SmlCoke/2026-MST3314-SonicBolt/README.md

<div align="center">

# ⚡️SonicBolt(声速闪电)
**数字集成电路设计 · 高性能 CNN 加速器全流程设计**

[]()   

[项目简介](#i-项目简介) • [仓库结构](#ii-仓库结构) • [各模块说明](#iii-各模块说明) • [Quick Start](#iv-quick-start-guide) • [设计进度](#v-设计进度)

</div>

---

## I. 项目简介

SonicBolt(声速闪电)项目为 SJTU MAST3314《数字集成电路设计课程设计》课程的完整设计仓库，目标是完成一款面向**语音关键词识别**的 CNN 加速器芯片全流程设计，采用工艺 SMIC18 ，预估实现目标：Speed ≥ 1000K frames/s ，评价指标：FoM = Speed / Area。覆盖架构设计、RTL 编码、逻辑仿真、逻辑综合、时序分析与物理设计。

**网络结构（MobileNet v2 简化版）**：

```
Input(1,30,10) → Conv(32,1,11,7) → ReLU
               → DWConv(32,1,3,3) → ReLU
               → PWConv(32,32,1,1) → ReLU
               → Maxpool(2×2, s=2)
               → Flatten(288)
               → FC(2,288)
               → Sigmoid → 二分类输出
```

所有卷积层采用 INT8 量化，中间累加使用 INT32，通过定点化乘移位（ $M0 × 2^{-n}$ ）重量化回 INT8。

---

## II. 仓库结构

```
CNN-Accelerator/
│
├── Demo/
│   ├── demo1-codex               # 第一版 Conv 层实现，由 Codex 5.3 生成，供参考学习
│   ├── demo2-claude              # 第二版 Conv 层实现，由 Claude Opus 4.6 生成，供参考学习 
│   ├── demo2-claude-opus         # 第三版 Conv 层实现，由 Claude Opus 4.6 生成，修复了第二版的 Bug 
│   └── pre-test/                 # 预览测试模块，与真实 RTL 实现基本无关，用于测试
│
├── Materials/                    # 课程资料
│   ├── introduction.md           # 课程简介与评分标准
│   ├── Design_Specifications.md  # 电路设计规范（网络结构、层参数、重量化公式）
│   ├── PyCode-Specifications.md  # Python 行为模型编写规范
│   ├── Coding-Styles.md          # Verilog 编码规范
│   ├── Re-quantization.md        # 量化细节与 M0/n 参数计算方法
│   ├── Skill-Plan.md             # 技能树与推进计划（参考）
│   └── SRAM_Requirements.md      # 片上 SRAM 需求表格
│
├── Notes/                        # 学习笔记
│   ├── demo                      # 示例 verilog 模块，与 slices/下的相关笔记一同阅读
│   ├── guide/                    # AI 给出的学习/涉及指导
│   └── slices/                   # 学习到的零散知识点 
│
├── PyRTL-CNN/                    # ★ Python 行为级仿真模型（本团队编写）
│   ├── load_params.py            # 参数加载模块
│   ├── rtl_primitives.py         # 底层硬件原语（SRAM / LineBuffer / MAC / Requant）
│   ├── layers.py                 # 各网络层类
│   ├── top_module.py             # 顶层推理模块
│   ├── run_inference.py          # 推理入口脚本
│   ├── test_golden.py            # 金标准对比验证
│   └── README.md                 # 详细说明与学习指南
│
├── Scripts/                      # 辅助脚本（如参数转换、仿真自动化等）
│   ├── interception.py           # git commit 时的审查与拦截脚本，原始版本
│   ├── pre_commit.py             # git commit 时的审查与拦截脚本，集成 python pre-commit 框架
│   └── search_files_by_name.py   # 根据文件名片段搜索文件
│
└── SonicBolt/                    # ★ RTL 实现（本团队编写）
    ├── data/                     # 测试数据和网络参数，供仿真使用
    ├── docs/                     # 设计文档、模块说明、架构示意图等 
    └── src/
        ├── conv/                 # Conv 层 RTL 实现
        ├── dwconv/               # DWConv 层 RTL 实现
        ├── pwconv/               # PWConv 层 RTL 实现
        ├── post_process/         # 后处理层 RTL 实现
        ├── utils/                # 公共模块（SRAM 封装、流水打拍、量化激活等）
        ├── cnn.v                 # 顶层模块，连接各子系统
        ├── cnn_chip.v            # 用于综合的顶层封装，删除了所有的对外 SRAM 接口。
        ├── cnn_test_tb.v         # 用于验证逐层输出是否正确的 testbench 模块
        ├── cnn_sim_tb.v          # 用于完整仿真验证的 testbench 模块
        ├── run_cnn_test_tb.py    # 自动化仿真脚本: 验证功能正确性 
        ├── run_cnn_sim_tb.py     # 自动化仿真脚本: 完整仿真496个样本
        ├── run_cnn_tb_common.py  # 自动化仿真脚本中的公共函数（如激励生成、结果验证等）
        └── README.md             # 详细说明与设计细节
```

## III. 各模块说明

### 3.1 `Materials/` — 课程资料

课程给定的设计规范文档，包含：
- 完整网络结构定义及各层参数（输入/输出尺寸、位宽、stride/padding）
- 重量化公式与各层 `(M0, n)` 参数
- 两种应用场景的指标要求（本团队选择**高性能场景**，Speed ≥ 1000K）

阅读起点：[Design_Specifications.md](Materials/Design_Specifications.md)

---

### 3.2 `PyRTL-CNN/` — Python 行为级仿真模型

在正式编写 Verilog 之前，用纯 Python 实现的完整 CNN 行为模型，作用：

1. **理解架构**：通过可执行代码直观学习片上 SRAM、行缓冲、MAC 阵列、重量化单元等硬件模块的工作原理
2. **RTL 映射参考**：每个 Python 类对应一个 Verilog 模块，数据流、位宽约束和地址计算与后续 RTL 设计保持一致
3. **Testbench 金标准**：提供逐层 INT8 参考输出，可直接用于验证 Verilog 仿真结果的数值正确性

**验证状态**：已通过全部层金标准对比（INT8 层逐元素完全匹配，Sigmoid FP32 误差 < 1e-6）。

快速验证：
```bash
cd PyRTL-CNN
python test_golden.py    # 逐层金标准对比
python run_inference.py  # 单样本推理，打印每层 I/O 尺寸
```

详见 [PyRTL-CNN/README.md](PyRTL-CNN/README.md)。

---

### 3.3 `Scripts/` — 辅助工具脚本

包含一些实用的脚本，如：
- `search_files_by_name.py`：根据文件名片段搜索项目中的相关文件，方便快速定位资料、参数或代码片段。使用方法：
  ```bash
  python search_files_by_name.py <root_directory> <filename_keyword>
  ```
- `interception.py`：git commit 时的审查与拦截脚本，可以用于检查提交信息规范、代码格式等。目前会审查 Conv/DWConv 子系统的版本号是否与说明文档 README.md 匹配，以及暂存区中的 `.v` 模块更新时间是否等于当前时间。具体使用方法参见：[SmlCoke: Git & Github 使用指南](https://smlcoke.com/tools/git/) 中 `hook` 机制这一节。
---

### 3.4 `Demo/` — AI 生成的示例实现

包含 Codex 5.3 和 Claude Opus 4.6 生成的多个版本的 Conv 实现，供学习和参考。

**注意**：这些实现可能存在功能性错误或性能问题，不建议直接使用于正式设计，但可以作为理解 Conv 层设计思路的参考。

> 此外，在 SonicBolt 的 Conv 实现后，`Demo/` 版本中的所有 Conv 模块由于位宽过大或者关键路径过长等各种原因，已经被正式舍弃，没有被应用到 SonicBolt 架构中。

---

### 3.5 `SonicBolt/` — Verilog RTL 实现

本团队针对**高性能场景**设计的 Verilog 实现，目标：

- 每秒处理 ≥ 1000K 帧 `(1,30,10)` 输入
- 评价指标：FoM = Speed / Area（面效）
- 设计方向：提升 MAC 并行度 + 流水线深度

架构示意图可以参照 [figures.pptx](./SonicBolt/docs/figures.pptx) ，其中涵盖了各个版本的电路架构示意图以及时序分析图，供设计参考。

这里不对架构实现做详细介绍，具体设计细节请参见：

1. 整体架构的设计说明文档：[SonicBolt/README.md](SonicBolt/README.md)
2. Conv 子系统的设计说明文档：[SonicBolt/src/conv/docs/README.md](SonicBolt/src/conv/docs/README.md)
3. DWConv 子系统的设计说明文档：[SonicBolt/src/dwconv/docs/README.md](SonicBolt/src/dwconv/docs/README.md)
4. PWConv 子系统的设计说明文档：[SonicBolt/src/pwconv/docs/README.md](SonicBolt/src/pwconv/docs/README.md)
5. Post Process 子系统的设计说明文档：[SonicBolt/src/post_process/docs/README.md](SonicBolt/src/post_process/docs/README.md)

当前**已实现完整功能版本**：
- CNN-v1.0: SonicBolt v5.1，全链路基础实现，包含所有功能，并且通过功能仿真验证
- CNN-v1.1: SonicBolt v5.2，新增**输入 Ping-Pong 缓存机制**，实现流水线连续计算
- CNN-v1.2: SonicBolt v5.3，将杂糅的状态转移逻辑重构为有限状态机写法，提升代码可读性和可维护性。
- CNN-v1.3: SonicBolt v5.4，新增**半窗缓存机制**，将 Conv 层的计算降低一半，代价是迭代周期从 72 增加至 80 。
- CNN-v1.4: SonicBolt v5.5，实现更激进的下一帧启动机制，在**控制逻辑复杂化程度较低**的情况下，将 Conv 层的迭代周期**从 103 进一步压缩至 89** ，成功实现了 $1000k fps$ 的性能指标。

**SonicBolt-PD 分支的各版本：**
- CNN-PD-v1.0: SonicBolt PD v1.0，基于 SonicBolt v5.5 构建。全链路基础实现，包含所有功能，删除了参数 SRAM 写接口，并且通过功能仿真验证，迭代周期仍为 89。
- CNN-PD-v1.1 解决了两处长关键路径(IC Compiler报告出时序违例): conv_tile_mac_row_mult 以及 fc_mac，此时迭代周期仍为 89
- CNN-PD-v1.2 继续清除了 DWConv 层以及 PWConv层的长路径，所有路径压缩至 2A/1M，测试迭代周期增加至 91
- CNN-PD-v1.3 在 IC Compiler 中进行多次物理设计后，发现大量时序违例问题，多次优化 tcl 脚本（包括解决 DFF 驱动能力、修复时钟树）均无果。经分析发现 placement 已经出现了明显 slack 问题，SonicBolt PD v1.3 版本打断了 input2reg 路径（source 主要是 img 输入数据），意图修复 placement 的问题。此时迭代周期为 91，并且该版本目前的物理设计违例情况是所有版本中最轻的一个，只有 -0.16ns，可以跑到 98 MHz，结合 91 的迭代周期，可以满足 1000kfps 的性能目标。

**SonicBolt-Lite 分支情况：**
- CNN-Lite-v1.0: 替换所有权重/偏置的 SRAM ，采用 ROM （即强制将权重/偏置值赋高低电平）实现，仅适合作为一个课程项目使用，迭代周期为 96。
- CNN-Lite-v1.1: 打断长组合路径进行了细粒度流水拆分并补齐边界握手
- CNN-Lite-v1.2: 全局总线改为 11 路本地 row ROM 直连

---

## IV. Quick Start Guide

### 4.1 环境准备

#### (1) Python 环境

Python 3.8+, 推荐使用 conda 管理环境：

#### (2) Verilog 仿真环境

本项目借助 Python 集成多个轻量级工具进行仿真测试，无需借助 `Modelsim`, `VCS`, `Vivado` 等重型EDA工具。需要用到的轻量级工具包括：
- `Icarus Verilog`：Verilog 编译器，用于编译 Verilog 模块和 testbench下
- `vvp`：Icarus Verilog 的仿真器，用于运行编译后的仿真文件
- `gtkwave`：波形查看工具，用于查看仿真结果的波形图

**Windows 环境下的安装方法：**

三个工具的下载链接：[https://bleyer.org/icarus/](https://bleyer.org/icarus/)
注意下载时勾选 `GTKWave` 组件。
安装完成后，将`bin\`目录添加进入环境变量，确保 `iverilog`, `vvp`, `gtkwave` 等命令可以在终端中直接使用。
更详细的安装教程可以参考：[SmlCoke: Verilog + VS Code 工具链配置](https://smlcoke.com/microelectronics/eda/vscode/) 或者 [SmlCoke: OSS CAD Suite](https://smlcoke.com/microelectronics/eda/oss-cad-suite/) 

**Linux (Ubuntu/Debian) 环境下的安装方法：**

可以直接使用 apt 包管理器安装：
```bash
sudo apt update
sudo apt install iverilog gtkwave -y
```

**MacOS 环境下的安装方法：**

推荐使用 Homebrew 进行安装：
```bash
brew install icarus-verilog gtkwave
```

#### (3) 运行仿真
```bash
cd SonicBolt/src
# 运行功能仿真验证
python run_cnn_test_tb.py
# 运行完整仿真验证(496个样本)
python run_cnn_sim_tb.py --start-sample 0 --sample-count 496
```

更多命令行参数以及仿真模式参见 [SonicBolt/src/run_cnn_test_tb.py](SonicBolt/src/run_cnn_test_tb.py) 和 [SonicBolt/src/run_cnn_sim_tb.py](SonicBolt/src/run_cnn_sim_tb.py)。

---

## V. Contributors and Design Progress

### 5.1 Design Progress

| 阶段 | 内容 | 状态 |
|---|---|---|
| 架构研究 | 阅读规范、建立 Python 行为模型 | ✅ 完成 |
| RTL 设计 | Verilog 模块编写（SonicBolt） | ✅ 完成 |
| 逻辑仿真 | Testbench 编写与功能验证 | ✅ 完成 |
| 逻辑综合 | Design Compiler，时序/面积/功耗分析 | ✅ 完成 |
| 物理设计 | ICC布局布线 | ✅ 完成 |

### 5.2 Contributors

<a href="https://github.com/SmlCoke/2026-MST3314-SonicBolt/graphs/contributors">
  
</a>
