SmlCoke/2026-MST3314-SonicBolt/SonicBolt/docs/figures-fj.pptx

Line Buffer

10× cols

1 pixel: INT 8

11× rows

flatten

0

9

10

19

20

29

## Slide 2

Line Buffer
滑窗卷积

10× cols

1 pixel: INT 8

11× rows

flatten

0

9

10

19

20

29

## Slide 3

Line Buffer
滑窗卷积

10× cols

1 pixel: INT 8

11× rows

flatten

0

9

10

19

20

29

## Slide 4

Conv1 架构分析

SRAM 接收地址
Pending = 1

SRAM 发送数据和valid
Pending = 0

SRAM 接收地址
Pending = 1

一次发送一个卷积核和一个偏置，总共77×8+16=632 bits

写入模型参数：

两个周期写入一次

一次发送一行输入，总共10×8=80 bits

Conv 进入参数加载状态

Valid=0

Conv 写入参数

Valid=0

SRAM 发送数据和valid
Pending = 0

SRAM 回收 valid

SRAM 接收地址
Pending = 1

写入行缓存：

三个周期写入一次

Conv 发送数据请求
sent = 1

Conv 接收数据，写入LB，sent = 0

Conv 发送数据请求
sent = 1

Next state 设置上升沿

Valid=0

疑惑：数据读取有点慢，平均每三个时钟周期才能读取一行数据，能否加速？

## Slide 5

Conv1 架构分析

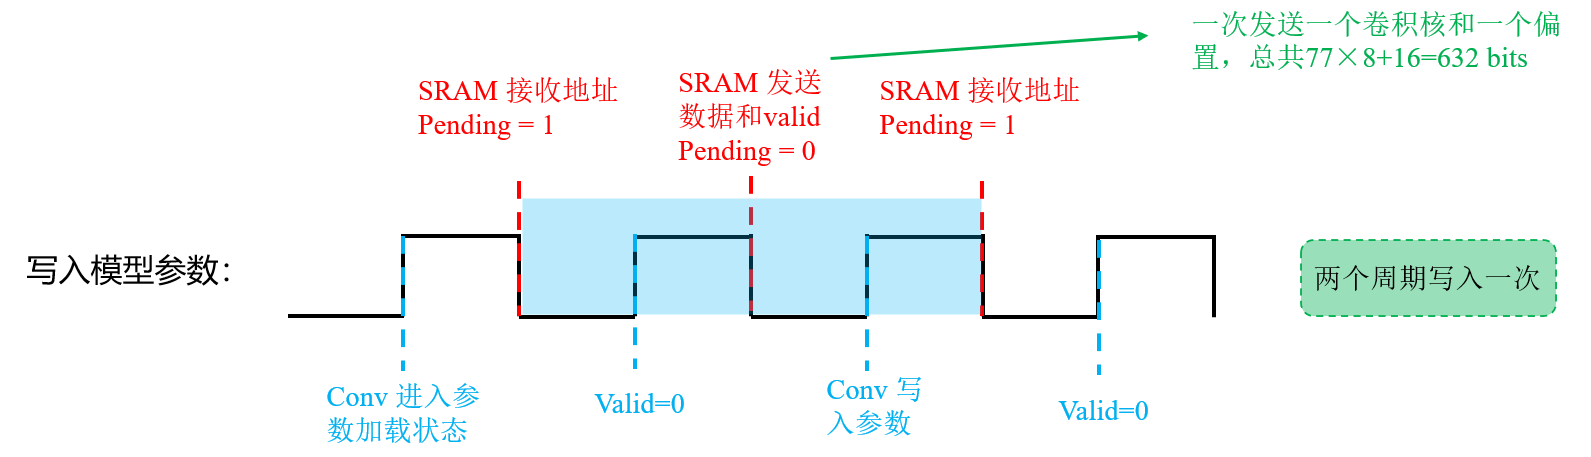
[picture p1: figure]
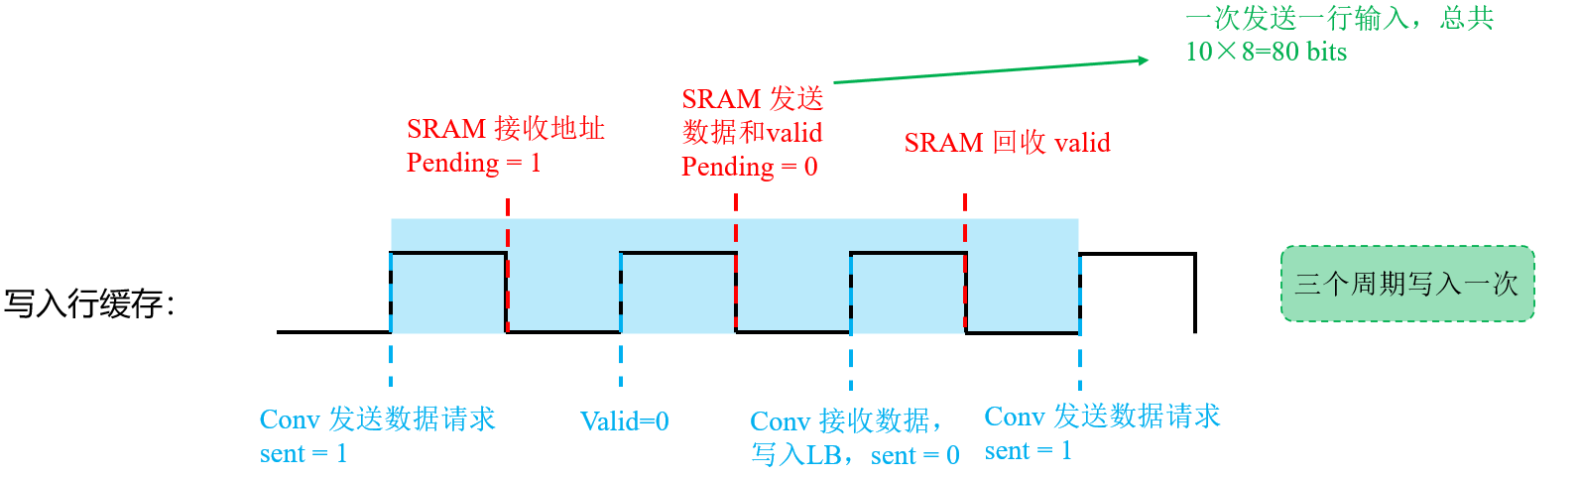
[picture p2: figure]

写入 Weight & Bias

写入 Line Buffer

两种写入模式不同，本质原因在于 wgt_req 和 in_row_req 不同，前者让 SRAM 主动连续发送数据，后者让 SRAM 必须听从 Conv 的请求才能发送数据

权重请求信号

输入请求信号

## Slide 6

Conv1 架构分析

计算流水线（五级）：

window 加载

Stage1: 乘法

Stage2: 加法1

Stage3: 加法2

Stage4: Res乘法

Stage4: 移位

输出一个pixel

col_cnt 更新

SRAM 接收地址
Pending = 1

SRAM 发送数据和valid
Pending = 0

col_cnt = 3
wait_row = 1

sent = 1
SRAM: in_row_req = 1

Conv 接收数据，写入LB，sent = 0, wait_row = 0

Conv 恢复计算

## Slide 7

Conv1 架构分析

计算流水线（五级）：

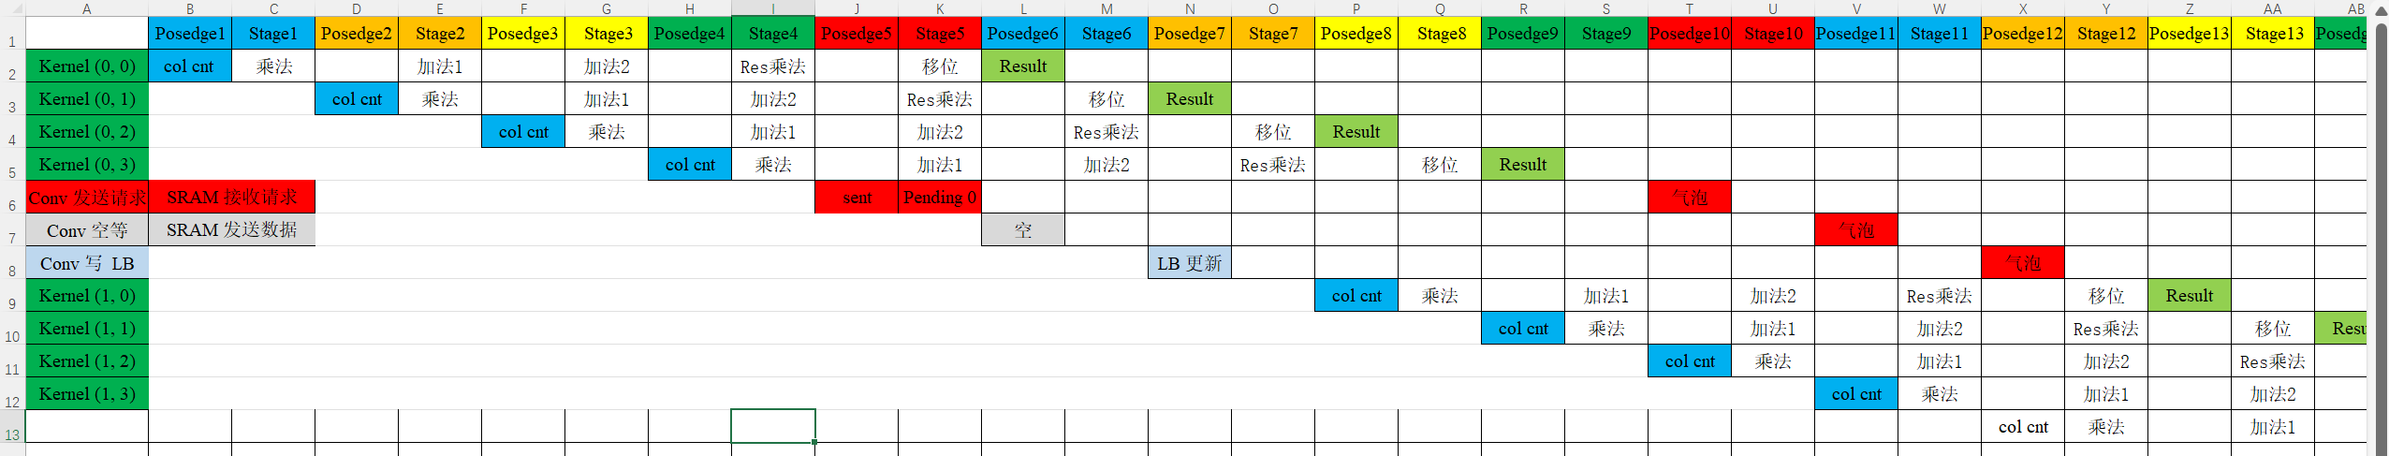
[picture p3: figure]

## Slide 8

Conv1 架构分析

漏水：

cnt = 1

cnt = 2

cnt = 3

cnt = 4

window 加载

col_cnt = 3
此时 wait_row 不再拉高，因为已经到了最后一行
组合逻辑，next state = DRAIN

Stage1: 乘法

进入漏水(DRAIN)状态
开始漏水计数

Stage2: 加法1

Stage3: 加法2

Stage4: Res乘法

漏水计数器计数完毕，设置 next state = DONE

Stage4: 移位

输出最后pixel

进入 DONE

下一个周期

进入 IDLE

结论：漏水计数器计数峰值=流水线深度-1

## Slide 9

MiniCNN 架构分析：数据流

(1) Conv 一个周期输入 1×14×10，输出1×4×4

(2) DWConv 一个周期输入 1×4×4，输出1×2×2

(3) PWConv 一个周期输入 1×2×2，输出1×2×2

(4) MaxPool 一个周期输入 1×2×2，输出1×1×1，九个元素中的一个

(5) cnt 代表当前在处理哪一个通道、pos代表当前在处理的属于MaxPool输出的九个元素中的哪一个

(6) 内部例化：
a. 8 个 SRAM 用于读权重，每个 SRAM 带宽 77 bits，一个次刚好读出一个卷积核
b. 1 个 SRAM 用于读偏置，带宽 32 bits

## Slide 10

MiniCNN 架构分析：Conv 时序模型

Stage 1: 加载 Input, Weight, Bias

select_data 采样
select_weight 采样
组合逻辑时间内组织出数据
cnt, pos更新

Stage 2: 并行计算出16个卷积结果，最小计算单元为7对INT8的MAC

Stage 3: 16 ×2 个并行计算单元，每个单元计算6个INT32 的 ADD

Stage 4: 16 个并行计算单元，每个单元计算2个INT32 的 ADD

Stage 5: 16 个并行计算单元，每个单元计算进行Rescale 的乘法

在一个 Verilog 模块中完成，因此该模块占了两拍。
同时该模块还要完成加载下一层卷积核的任务（一个SRAM，带宽72 bits）

Stage 6: 16 个并行计算单元，每个单元计算进行Rescale 的移位

rst=0

cnt=0
pos=0

注！Conv下属所有子模块全部并行！
也就是说每个周期都在同时参与运算，但是我们只要保障Input, Weight, Bias同步读取就行，事实上也确实如此。模块内部通过 pos信号和cnt信号以及他们的附属信号确保同步。

## Slide 11

MiniCNN 架构分析：Conv 时序模型

Stage 1: 并行计算出16个卷积结果，最小计算单元为7对INT8的MAC

INT32

Cell 0

共16组

……

共16组

operand1

operand2

Cell 1

BIAS

Stage 2: 16 ×2 个并行计算单元，每个单元计算6个INT32 的 ADD

Stage 3: 16 个并行计算单元，每个单元计算2个INT32 的 ADD

## Slide 12

MiniCNN 架构分析：DWConv 时序模型

Conv的计算完毕，DWC data group 完毕，Input 和 Weight 准备好

Stage 1: 4个并行计算单元，进行9个INT 8 的 MAC，
同时加载BIAS

Stage 2: 4个并行计算单元，每个单元计算3个INT32 的 ADD

这里的3个 INT32 分别是2个 Data 和1个 Bias

Stage 4: 4 个并行计算单元，每个单元计算进行Rescale 的乘法

在一个 Verilog 模块中完成，因此该模块占了两拍。
同时该模块还要完成加载下一层卷积核的任务（一个SRAM，带宽72 bits）

Stage 5: 4 个并行计算单元，每个单元计算进行Rescale 的移位

Stage 6: 将结果打到寄存器（4组）、同时读取PWC 该通道的权重

cnt=0
pos=0

select_data 输送
select_bias 采样
cnt, pos更新

这里为什么要在输入端准备好Input和Weight？因为要确保Channel匹配

注！PWC的卷积核形状是：32, 32, 1, 1，每个周期会读出一个输出通道需要用到的32通道权重（32个 INT 8）
这样，读完所有卷积核需要32个周期，而pos填满32个通道也需要32个周期，可以实现无停顿流水。
只是每个pos要重新读一遍权重。
cnt=31， DWConv输出完32 Channels，下一个时钟上升沿，Channel 0的Kernel加载，之后PWC MAC组合逻辑计算

## Slide 13

MiniCNN 架构分析：DWConv 时序模型

共4组

共4组

operand1

operand2

bias

Stage 1: 4个并行计算单元，进行9个INT 8 的 MAC，同时加载BIAS

Stage 2: 4个并行计算单元，每个单元计算3个INT32 的 ADD

## Slide 14

MiniCNN 架构分析：PWConv 时序模型

cnt=31，所有32 Channels 数据加载完毕

Stage 1: 加载 Bias,
4 路并行计算，每路八组并行计算4个 INT 8 MAC

cnt, pos更新
cnt = 0，该上升沿加载 Kernel 0
之后整个时钟周期，组合逻辑吸收 Kernel，传播计算

Stage 2: 4路并行计算，每路计算8个INT 32和1个 BIAS（INT 32）

在一个 Verilog 模块中完成，因此该模块占了两拍。

Stage 3: 4 个并行计算单元，每个单元计算进行Rescale 的乘法

在一个 Verilog 模块中完成，因此该模块占了两拍。

Stage 4: 4 个并行计算单元，每个单元计算进行Rescale 的移位和ReLU

## Slide 15

MiniCNN 架构分析：PostProcess 时序模型(MaxPool+FC+Resc+Sigmoid)

Stage 1: MaxPool(4, 4)，同时加载FC权重
同时加载FC偏置

Stage 2: 2路并行，FC矩阵乘法，与权重相乘后加到data_out

Stage 3: 2 个并行计算单元，每个单元计算进行Rescale 的乘法

Stage 4: 2 个并行计算单元，每个单元计算进行Rescale 的移位

Stage 5: 最后的Float32结果根据INT8 查表得出，一拍

……

共9×32=288个周期

在一个 Verilog 模块中完成，因此该模块占了两拍。

## Slide 16

MiniCNN 架构分析：优缺点

- 优点
  - 1. 高度并行化的输入计算，14×10→4×4→2×2→2×2→1，9×32=288个周期即可计算完毕FC输出向量，架构清晰易懂，cnt 和 pos 构建二位空间索引指明当前位置
  - 2. 不用消耗过多存储存放参数和输入，所有参数与输入都是随用随取

- 缺点
  - 1. 重复计算：发生在大窗口移动后，大量卷积窗口发生重复计算，这一点造成了大量不必要的动态功耗！
  - 2. 状态信号缺失，数据同步全程依赖严格的cnt和pos及其附属子信号对齐，但是这一点既是坏处，也是好处。代价就是各级顶层模块的子模块定义相当混乱，无法肉眼看出子模块的流水阶段，可读性差。
  - 3. 除此之外还有许多额外操作，例如第一轮DWC→PWC传播时，32通道没有填满，PWC没有任何 stage 在流水，但是 weight 仍然傻乎乎的每周期切换。

## Slide 17

SonicBolt v1 架构分析

- conv_shared_input_buffer: 输入侧

pos_req_pos →(组合逻辑) 提取pos_window_now

读时序：

pos_req_valid 变为有效
pos_req_pos更新

pos_window_valid 变为有效
pos_window_data 获取 pos_window_now数据

写时序：

img_wr信号组变为有效：
img_wr_en, img_wr_buf_sel, img_wr_addr, img_wr_data_lo, img_wr_data_hi

frame_cache根据输入地址写入数据

## Slide 18

SonicBolt v1 架构分析

- conv_shared_input_buffer: 输入侧

组合逻辑时间内，active_frame_bus根据active_buf_sel切换输入寄存器总线

切换时序：

active_buf_sel切换为start_buf_sel

start_consume, start_buf_sel变为有效

## Slide 19

SonicBolt v1 架构分析

- conv_sram_sp: SRAM 行为模型

写时序：

wr_en有效
addr有效
wdata有效

写入

读时序：

rd_en有效
addr(1)有效

old_word(1)
rdata(1)
addr(2)更新

old_word(2)
rdata(2)
addr(3)更新

## Slide 20

SonicBolt v1 架构分析

- conv_tile_mac 的时序模型

Stage1:
数据打拍，
元数据打拍

元数据：
valid, last, pos, group

stage2:
kernel_row 卷积

一共 4 个输出通道，每个通道 kernel_row 维度 (7, 1)，输入数据的维度 (4, 10)，kernel_row 滑动 16 次，每次做 7 组 INT8 的乘累加，想想为什么要这样滑动

## Slide 21

SonicBolt v1 架构分析

- conv_tile_mac: 数据形状变化（stage1）

## Slide 22

SonicBolt v1 架构分析

- conv_core 状态信号更迭

issue_count = 69
next_issue_count = 70
issue_fire = 1

issue_count = 70，进而 issue_fire = 1, next_issue_count = 71

busy = 1

issue_count = 71，进而 issue_fire = 0, next_issue_count停止更新

And

pos_req_valid

向输入存储器发送请求

weight_rd_en

权重 SRAM 使能

issue_count < 71

issue_fire

bias_rd_en

偏置 SRAM 使能

stage0_valid

tile_mac 输入元数据

## Slide 23

SonicBolt v1 架构分析

- conv_subsystem 时序模型

……

Tile_mac识别到mac_in_valid=1，启动五级流水线

……

紧接着是rescale_relu的三级流水线

start→1

start→0
busy→1
issue_pos→0
issue_group→0
issue_count→0

conv_core读到输入数据有效信号（总线直连输入数据和权重/偏置），置mac_in_valid=1

Input buffer, wt/bs SRAM 继续发送新的数据

conv_core识别到issue_fire，更新状态计数器

Input buffer识别到pos_req_valid，置pos_window_valid=1，并输出一组数据窗口（其实这个窗口一直在，只是此时有效了）

Wt/bs SRAM 接受到en和addr，组织好数据

issue_fire→1
pos_req_valid→1
wt_rd_en→1
bs_rd_en→1
并发送地址

Input buffer识别到start，标记active buffer总线

## Slide 24

SonicBolt Conv v2.0 mini 架构分析

SRAM

reg

- conv_subsystem 架构电路图

Tile MAC
(1+n stage)

Input Reg Array: 80bit per reg

Weight Reg Array: 224bit per reg

14x10x8bit

(14/12)x10x8bit

0

1

0

2

3

4

······

Comb Logic

12

10

13

Rescale-ReLU-SAT Path
(2 stage)

ReLU
512bit

Rescale
2048bit

SRAM 0
(30x80bit)

1x10x8bit

SRAM 1
(30x80bit)

Cache 0
(14x10x8bit)

1120bit

BIAS

64x32bit

1

2

······

2048bit

prefetched
(2x10x8bit)

2x10x8bit

pos_row_data_bus
(14x80bit)

MUX

Comb Logic

Comb Logic

2048

Comb Logic

2048

512bit

Cache 1
(14x10x8bit)

(14/12)x10x8bit

Input Buffer

······

2464bit

SRAM w1
8x224bit

64bit

Param Store

SRAM w0
8x224bit

SRAM w2
8x224bit

······

SRAM w9
8x224bit

SRAM w10
8x224bit

SRAM b0
8x64bit

## Slide 25

SonicBolt Conv v2.0 mini 架构分析

- conv_shared_input_buffer 时序模型：pos逻辑

相比v1直接把所有输入参数存在片上reg中，这个版本只存14x工作10阵列+2x10预取行缓存，节省了14/30约等于50%

pos_req_valid变为有效

start_consume→1
开始消费

active_buf_sel 接收 start_buf_sel
pos_window_valid置0
current_pos置0
workset_loaded置0
prefetched_valid置0
prefetch_step置0
rd_wait_pending置0
rd_capture_pending置0

(1) 首建工作集且pos=0
pos_row_data从shadow_cache中取数据
current_pos置0
workset_loaded置1
pos_window_valid置1
prefetched_valid置0
prefetch_step置0
(2) 工作集存在且pos=current_pos
pos_window_valid置1，其余不变
(3) 工作集存在，且pos=current_pos+1
如果预取有效，则旧行滚动，新行插入，current_pos更新，预取有效信号置0；否则判定失败
(4) 判定失败

## Slide 26

SonicBolt Conv v2.0 mini 架构分析

- conv_shared_input_buffer 时序模型：预取逻辑

工作集加载成功，当前pos<8，consume_tick=1时进入预取逻辑

prefetch_step=0

prefetch_step=1

Rd_capture_slot=0，预取第1行

预取发起逻辑

如果rd_wait_pending和rd_capture_pending为0
active_rd_en_reg置1
active_rd_addr_reg获取地址
rd_wait_pending置1
rd_capture_slot置0
prefetch_step置1

预取返回逻辑

rd_wait_pending置0
rd_capture_pending置1

预取返回逻辑

Prefetch_row取数据
Rd_capture_pending置0

预取发起逻辑

如果rd_wait_pending和rd_capture_pending为0
active_rd_en_reg置1
active_rd_addr_reg获取地址
rd_wait_pending置1
rd_capture_slot置1
prefetch_step置2

rdata根据上一拍的addr以及en信号，准备数据

SRAM

active_rd_en每周期置0，SRAM无效

SRAM

预取发起逻辑无事发生

## Slide 27

SonicBolt Conv v2.0 mini 架构分析

- conv_shared_input_buffer 时序模型：预取逻辑

工作集加载成功，当前pos<8，consume_tick=1时进入预取逻辑

prefetch_step=2

Rd_capture_slot=1，预取第2行

预取发起逻辑

如果rd_wait_pending和rd_capture_pending为0
active_rd_en_reg置1
active_rd_addr_reg获取地址
rd_wait_pending置1
rd_capture_slot置1
prefetch_step置2

预取返回逻辑

rd_wait_pending置0
rd_capture_pending置1

预取返回逻辑

prefetch_row取数据
rd_capture_pending置0
prefetched_valid置1
prefetch_step置3

预取发起逻辑无事发生

rdata根据上一拍的addr以及en信号，准备数据

SRAM

prefetched_valid有效，
工作集更新，window_valid置1

Pos请求

预取发起逻辑无事发生

预取发起逻辑无事发生

## Slide 28

SonicBolt Conv v2.0 mini 架构分析

- conv_core时序模型：从init开始

外部使start=1，
start_buf_sel有效

conv_core状态机

busy置1→req_inti_pos=1，pos_req_valid=1

Input_buffer

pos_row_data_bus加载工作集，window valid

conv_core状态机

conv_core状态机

stage0元数据有效(valid, pos, count, last)
issue_count 更新
issue_group, issue_pos
→更新地址，但是此时SRAM读的仍是之前地址
consume_stick有效

tile_mac 核心

第一拍，wire形式的输入数据/参数读入内部reg，与总线断开，输入元数据读入内部reg[0]

Input_buffer

active_buf_sel接收start_buf_sel

issue_fire仍为0, window valid后变为1

en信号有效，送出数据

conv_core状态机

输入元数据更新；pos-group更新

参数 SRAM

下一个token

参数 SRAM

SRAM en信号=issue_fire，fire置1后有效

参数 SRAM

en信号有效，送出数据

## Slide 29

SonicBolt Conv v2.0 mini 架构分析

- conv_core时序模型：从init开始

tile_mac 核心

第一拍，wire形式的输入数据/参数读入内部reg，与总线断开，输入元数据读入内部reg[0]

tile_mac 核心

第二拍，一个时钟周期内完成64个卷积核的运算，输入元数据从内部reg[0]转移到reg[1]

rescale_relu 链路

rescale_relu第一级流水，rescale

rescale_relu 链路

rescale_relu第二级流水，ReLU+Saturate

en信号有效，送出数据

conv_core状态机

输入元数据更新；pos-group更新

参数 SRAM

下一个token

下一个token

第一拍，wire形式的输入数据/参数读入内部reg，与总线断开，输入元数据读入内部reg[0]

······

## Slide 30

SonicBolt Conv v2.0 mini 架构分析(综合分析)

同时考虑conv_core, input_buffer, SRAM

外部使start=1，
start_buf_sel有效

issue_pos=0, issue_group=0

issue_pos=0, issue_group=1

issue_pos=0, issue_group=2

conv_core状态机

busy置1→req_inti_pos=1，pos_req_valid=1

Input_buffer

pos_row_data_bus加载工作集，window valid

conv_core状态机

conv_core状态机

stage0元数据有效(valid, pos, count, last)
issue_count 更新
issue_group, issue_pos
→更新地址，但是此时SRAM读的仍是之前地址
consume_tick有效

tile_mac 核心

第一拍，wire形式的输入数据/参数读入内部reg，与总线断开，输入元数据读入内部reg[0]

Input_buffer

active_buf_sel接收start_buf_sel

issue_fire仍为0, window valid后变为1

en信号有效，送出数据

conv_core状态机

输入元数据更新；pos-group更新

预取发起逻辑：输入SRAM en拉高
prefetch_step置1

参数 SRAM

第二个token

参数 SRAM

SRAM en信号=issue_fire，fire置1后有效

参数 SRAM

en信号有效，送出数据

## Slide 31

SonicBolt Conv v2.0 mini 架构分析(综合分析)

同时考虑conv_core, input_buffer, SRAM

issue_pos=0, issue_group=2

issue_pos=0, issue_group=3

issue_pos=0, issue_group=4

issue_pos=0, issue_group=5

tile_mac 核心

第一拍，wire形式的输入数据/参数读入内部reg，与总线断开，输入元数据读入内部reg[0]

tile_mac 核心

第二拍，一个时钟周期内完成64个卷积核的运算，输入元数据从内部reg[0]转移到reg[1]

rescale_relu 链路

rescale_relu第一级流水，rescale

rescale_relu 链路

rescale_relu第二级流水，ReLU+Saturate

en信号有效，送出数据

conv_core状态机

输入元数据更新；pos-group更新

预取返回逻辑：pending
输入SRAM接收en信号，准备好输出数据
prefetch_step=1

第二个token

en信号有效，送出数据

conv_core状态机

输入元数据更新；pos-group更新

预取返回逻辑：新行数据存入寄存器
输入SRAM不工作，无事发生

第三个token

en信号有效，送出数据

conv_core状态机

输入元数据更新；pos-group更新

预取发起逻辑：输入SRAM en拉高
prefetch_step置2

en信号有效，送出数据

conv_core状态机

输入元数据更新；pos-group更新

预取返回逻辑：pending
输入SRAM接收en信号，准备好输出数据
prefetch_step=2

参数 SRAM

参数 SRAM

参数 SRAM

第四个token

参数 SRAM

第五个token

## Slide 32

SonicBolt Conv v2.0 mini 架构分析(综合分析)

同时考虑conv_core, input_buffer, SRAM

issue_pos=0, issue_group=6

issue_pos=0, issue_group=7

issue_pos=1, issue_group=0

issue_pos=1, issue_group=1

第六个token

第七个token

第八个token

en信号有效，送出数据

conv_core状态机

输入元数据更新；pos-group更新

en信号有效，送出数据

conv_core状态机

输入元数据更新；pos-group更新

参数 SRAM

en信号有效，送出数据

conv_core状态机

输入元数据更新；pos-group更新

conv_core状态机

参数 SRAM

en信号有效，送出数据

conv_core状态机

输入元数据更新；pos-group更新

参数 SRAM

参数 SRAM

第一个token

req_next_pos激活
pos_req_pos激活，且＝1

input buffer无事发生

预取返回逻辑：新行数据存入寄存器
输入SRAM不工作，无事发生

pos请求逻辑：接收到pos_req_valid信号，生成输入window，window valid
便于下一个时钟上升沿，conv_core核心读取数据

## Slide 33

SonicBolt Conv v2.0 mini 架构分析(综合分析)

同时考虑conv_core, input_buffer, SRAM

issue_pos=8, issue_group=0

conv_core状态机

issue_fire = 0
对参数sram的en信号拉低
req_next_pos不再请求

issue_count = 72

## Slide 34

SonicBolt Conv v2.0 架构分析

SRAM

reg

- conv_subsystem 架构电路图

Tile MAC
(3 stage)

11unit
64 window per unit

pipe

Stage 2

14x10x8bit

(14/12)x10x8bit

weight

window

bias

Stage 1

2464bit

11x1216bit

64 unit
(11 sum + 1 bias per unit)

Stage 3

Rescale-ReLU-SAT Path
(2 stage)

ReLU
512bit

Rescale
2048bit

SRAM 0
(30x80bit)

Cache 0
(14x10x8bit)

1120bit

1120bit

2048bit

1x10x8bit

prefetched
(2x10x8bit)

2x10x8bit

pos_row_data_bus
(14x80bit)

MUX

64bit

512bit

SRAM 1
(30x80bit)

Cache 1
(14x10x8bit)

(14/12)x10x8bit

Input Buffer

64bit

2464bit

SRAM w1
8x224bit

64bit

Param Store

SRAM w0
8x224bit

SRAM w2
8x224bit

······

SRAM w9
8x224bit

SRAM w10
8x224bit

SRAM b0
8x64bit

## Slide 35

SonicBolt Conv v2.0 架构分析

- conv_shared_input_buffer 时序模型：pos逻辑

相比v1直接把所有输入参数存在片上reg中，这个版本只存14x工作10阵列+2x10预取行缓存，节省了14/30约等于50%

pos_req_valid变为有效

start_consume→1
开始消费

active_buf_sel 接收 start_buf_sel
pos_window_valid置0
current_pos置0
workset_loaded置0
prefetched_valid置0
prefetch_step置0
rd_wait_pending置0
rd_capture_pending置0

(1) 首建工作集且pos=0
pos_row_data从shadow_cache中取数据
current_pos置0
workset_loaded置1
pos_window_valid置1
prefetched_valid置0
prefetch_step置0
(2) 工作集存在，且pos=current_pos+1
如果预取有效，则旧行滚动，新行插入，current_pos更新，预取有效信号置0；否则判定失败
(3) 一般来说不会有这个情况，直接PASS

## Slide 36

SonicBolt Conv v2.0 架构分析

- conv_shared_input_buffer 时序模型：预取逻辑

工作集加载成功，当前pos<8，consume_tick=1时进入预取逻辑

prefetch_step=0

prefetch_step=1

Rd_capture_slot=0，预取第1行

预取发起逻辑

如果rd_wait_pending和rd_capture_pending为0
active_rd_en_reg置1
active_rd_addr_reg获取地址
rd_wait_pending置1
rd_capture_slot置0
prefetch_step置1

预取返回逻辑

rd_wait_pending置0
rd_capture_pending置1

预取返回逻辑

Prefetch_row取数据
Rd_capture_pending置0

预取发起逻辑

如果rd_wait_pending和rd_capture_pending为0
active_rd_en_reg置1
active_rd_addr_reg获取地址
rd_wait_pending置1
rd_capture_slot置1
prefetch_step置2

rdata根据上一拍的addr以及en信号，准备数据

SRAM

active_rd_en每周期置0，SRAM无效

SRAM

预取发起逻辑无事发生

## Slide 37

SonicBolt Conv v2.0 架构分析

- conv_shared_input_buffer 时序模型：预取逻辑

工作集加载成功，当前pos<8，consume_tick=1时进入预取逻辑

prefetch_step=2

Rd_capture_slot=1，预取第2行

预取发起逻辑

如果rd_wait_pending和rd_capture_pending为0
active_rd_en_reg置1
active_rd_addr_reg获取地址
rd_wait_pending置1
rd_capture_slot置1
prefetch_step置2

预取返回逻辑

rd_wait_pending置0
rd_capture_pending置1

预取返回逻辑

prefetch_row取数据
rd_capture_pending置0
prefetched_valid置1
prefetch_step置3

预取发起逻辑无事发生

rdata根据上一拍的addr以及en信号，准备数据

SRAM

prefetched_valid有效，
工作集更新，window_valid置1

Pos请求

预取发起逻辑无事发生

预取发起逻辑无事发生

## Slide 38

SonicBolt Conv v2.0 架构分析(综合分析)

同时考虑conv_core, input_buffer, SRAM

外部使start=1，
start_buf_sel有效

issue_pos=0, issue_group=0

issue_pos=0, issue_group=1

issue_pos=0, issue_group=2

conv_core状态机

busy置1→req_inti_pos=1，pos_req_valid=1

Input_buffer

pos_row_data_bus加载工作集，window valid

conv_core状态机

conv_core状态机

stage0元数据有效(valid, pos, count, last)
issue_count 更新
issue_group, issue_pos
→更新地址，但是此时SRAM读的仍是之前地址
consume_tick有效

tile_mac 核心

第一拍，wire形式的输入数据/参数读入内部reg，与总线断开，输入元数据读入内部reg[0]

计算核心

数据
通
信时序

预取逻辑

Input_buffer

active_buf_sel接收start_buf_sel

issue_fire仍为0, window valid后变为1

en信号有效，送出数据

conv_core状态机

输入元数据更新；pos-group更新

预取发起逻辑：输入SRAM en拉高
prefetch_step置1

参数 SRAM

第二个token

参数 SRAM

SRAM en信号=issue_fire，fire置1后有效

参数 SRAM

en信号有效，送出数据

## Slide 39

SonicBolt Conv v2.0 架构分析(综合分析)

同时考虑conv_core, input_buffer, SRAM

issue_pos=0, issue_group=2

issue_pos=0, issue_group=3

issue_pos=0, issue_group=4

issue_pos=0, issue_group=5

计算核心

数据
通
信时序

预取逻辑

tile_mac 核心

第一拍，wire形式的输入数据/参数读入内部reg，与总线断开，输入元数据读入内部reg[0]

tile_mac 核心

第二拍，每个group分为11组，每组对应4个kernel的同一行，每一行面向4行input row，做乘累加

tile_mac 核心

第三拍，64个并行计算单元，每个计算单元从第二排的结果得到11个部分和，连同bias一起做加法

rescale_relu 链路

rescale_relu第一级流水，Rescale

en信号有效，送出数据

conv_core状态机

输入元数据更新；pos-group更新

预取返回逻辑：pending
输入SRAM接收en信号，准备好输出数据
prefetch_step=1

第二个token

en信号有效，送出数据

conv_core状态机

输入元数据更新；pos-group更新

预取返回逻辑：新行数据存入寄存器
输入SRAM不工作，无事发生

第三个token

en信号有效，送出数据

conv_core状态机

输入元数据更新；pos-group更新

预取发起逻辑：输入SRAM en拉高
prefetch_step置2

en信号有效，送出数据

conv_core状态机

输入元数据更新；pos-group更新

预取返回逻辑：pending
输入SRAM接收en信号，准备好输出数据
prefetch_step=2

参数 SRAM

参数 SRAM

参数 SRAM

第四个token

参数 SRAM

第五个token

## Slide 40

SonicBolt Conv v2.0 架构分析(综合分析)

同时考虑conv_core, input_buffer, SRAM

issue_pos=0, issue_group=6

issue_pos=0, issue_group=7

issue_pos=1, issue_group=0

issue_pos=1, issue_group=1

conv_core状态机

req_next_pos激活
pos_req_pos激活，且＝1

计算核心

数据
通
信时序

预取逻辑

rescale_relu 链路

rescale_relu第二级流水，ReLU+Saturate

DWConv

en信号有效，送出数据

conv_core状态机

输入元数据更新；pos-group更新

pos请求逻辑：接收到pos_req_valid信号，生成输入window，window valid
便于下一个时钟上升沿，conv_core核心读取数据

DWConv

en信号有效，送出数据

conv_core状态机

输入元数据更新；pos-group更新

en信号有效，送出数据

conv_core状态机

输入元数据更新；pos-group更新

预取返回逻辑：新行数据存入寄存器
输入SRAM不工作，无事发生

参数 SRAM

第五个token

en信号有效，送出数据

conv_core状态机

输入元数据更新；pos-group更新

input buffer无事发生

参数 SRAM

第七个token

参数 SRAM

第八个token

参数 SRAM

第一个token

## Slide 41

SonicBolt Conv v2.0 架构分析(综合分析)

同时考虑conv_core, input_buffer, SRAM

issue_pos=8, issue_group=0

conv_core状态机

issue_fire = 0
对参数sram的en信号拉低
req_next_pos不再请求

issue_count = 72

## Slide 42

SonicBolt Conv v2.1 架构分析

SRAM

reg

- conv_subsystem 架构电路图

Tile MAC
(3 stage)

11unit
64 window per unit

pipe

Stage 2

14x10x8bit

(14/12)x10x8bit

weight

window

bias

Stage 1

2464bit

11x1216bit

64 unit
(11 sum + 1 bias per unit)

Stage 3

Rescale-ReLU-SAT Path
(2 stage)

ReLU
512bit

Rescale
2048bit

Cache
(14x10x8bit)

1x10x8bit

prefetched
(2x10x8bit)

1120bit

1120bit

2048bit

SRAM
(30x80bit)

pos_row_data_bus
(14x80bit)

MUX

64bit

512bit

64bit

Input Buffer

2464bit

SRAM w1
8x224bit

64bit

Param Store

SRAM w0
8x224bit

SRAM w2
8x224bit

······

SRAM w9
8x224bit

SRAM w10
8x224bit

SRAM b0
8x64bit

## Slide 43

SonicBolt Conv v2.1 架构分析

- conv_shared_input_buffer 时序模型：pos逻辑

相比v1直接把所有输入参数存在片上reg中，这个版本只存14x工作10阵列+2x10预取行缓存，节省了14/30约等于50%

pos_req_valid变为有效

相比v2.0，这里删除了sel信号

start_consume→1
开始消费

pos_window_valid置0
current_pos置0
workset_loaded置0
prefetched_valid置0
prefetch_step置0
rd_wait_pending置0
rd_capture_pending置0

(1) 首建工作集且pos=0
pos_row_data从shadow_cache中取数据
current_pos置0
workset_loaded置1
pos_window_valid置1
prefetched_valid置0
prefetch_step置0
(2) 工作集存在，且pos=current_pos+1
如果预取有效，则旧行滚动，新行插入，current_pos更新，预取有效信号置0；否则判定失败
(3) 一般来说不会有这个情况，直接PASS

## Slide 44

SonicBolt Conv v2.1 架构分析

- conv_shared_input_buffer 时序模型：预取逻辑
  - 预取逻辑与 v2.0 完全一致，参加 v2.0 一节的 Slice

## Slide 45

SonicBolt Conv v2.1 架构分析(综合分析)

- 除了删除 sel 信号外，这一节分析也与 v2.0 完全一致，参见 v2.0 一节即可

同时考虑conv_core, input_buffer, SRAM

## Slide 46

SonicBolt Conv v2.2 架构分析

SRAM

reg

- conv_subsystem 架构电路图

Tile MAC
(3 stage)

11unit
64 window per unit
（pipe → compute ）

14x10x8bit

(14/12)x10x8bit

Stage 2

11x1216bit

64 unit
(11 sum + 1 bias per unit， 2 stage)

Stage 3, 4

Rescale-ReLU-SAT Path
(2 stage)

ReLU
512bit

Rescale
2048bit

Cache
(14x10x8bit)

1x10x8bit

prefetched
(2x10x8bit)

1120bit

2048bit

SRAM
(30x80bit)

pos_row_data_bus
(14x80bit)

MUX

64bit

512bit

bias

Stage 1

64bit

pipe

Stage 2

Input Buffer

2464bit

SRAM w1
8x224bit

64bit

Param Store

SRAM w0
8x224bit

SRAM w2
8x224bit

······

SRAM w9
8x224bit

SRAM w10
8x224bit

SRAM b0
8x64bit

## Slide 47

SonicBolt Conv v2.2 架构分析(综合分析)

- conv_core 流水线级数从原来的5级增长为6级，除此之外时序模型基本不变。
- 唯一要注意的是，预取逻辑相比conv_core计算会更早结束（因为conv_core计算完一个token的时间变长了），时序裕度提升，这对我们来说是好事

同时考虑conv_core, input_buffer, SRAM

这里会多涨一级流水！

计算核心

数据
通
信时序

预取逻辑

tile_mac 核心

第一拍，wire形式的输入数据/参数读入内部reg，与总线断开，输入元数据读入内部reg[0]

tile_mac 核心

第二拍，每个group分为11组，每组对应4个kernel的同一行，每一行面向4行input row，做乘累加

tile_mac 核心

第三拍，64个并行计算单元，每个计算单元从第二排的结果得到11个部分和，连同bias一起做加法

rescale_relu 链路

rescale_relu第一级流水，Rescale

en信号有效，送出数据

conv_core状态机

输入元数据更新；pos-group更新

预取返回逻辑：pending
输入SRAM接收en信号，准备好输出数据
prefetch_step=1

第二个token

en信号有效，送出数据

conv_core状态机

输入元数据更新；pos-group更新

预取返回逻辑：新行数据存入寄存器
输入SRAM不工作，无事发生

第三个token

en信号有效，送出数据

conv_core状态机

输入元数据更新；pos-group更新

预取发起逻辑：输入SRAM en拉高
prefetch_step置2

en信号有效，送出数据

conv_core状态机

输入元数据更新；pos-group更新

预取返回逻辑：pending
输入SRAM接收en信号，准备好输出数据
prefetch_step=2

参数 SRAM

参数 SRAM

参数 SRAM

第四个token

参数 SRAM

第五个token

## Slide 48

SonicBolt Conv v2.5 架构分析

SRAM

reg

- conv_subsystem 架构电路图

Tile MAC
(4 stage)

Stage 1，2

11unit
64 window per unit
（pipe → compute ）

14x10x8bit

(14/12)x10x8bit

11x1216bit

64 unit
(11 sum + 1 bias per unit， 2 stage)

Stage 3, 4

Rescale-ReLU-SAT Path
(2 stage)

ReLU
512bit

Rescale
2048bit

Cache
(14x10x8bit)

1x10x8bit

prefetched
(2x10x8bit)

1120bit

2048bit

SRAM
(30x80bit)

pos_row_data_bus
(14x80bit)

MUX

64bit

512bit

bias

Stage 1

64bit

pipe

Stage 2

Input Buffer

weight sram:
depth = 8
word width = 224

SRAM w0
8x224bit

2464bit

SRAM w1
8x224bit

64bit

bias sram:
depth = 8
word width = 64

SRAM b0
8x64bit

Param Store

SRAM w2
8x224bit

······

SRAM w9
8x224bit

SRAM w10
8x224bit

## Slide 49

SonicBolt DWConv v1.0 架构分析

SRAM

reg

- dwconv_subsystem 架构电路图

Tile MAC
(3 stage)

3x288bit

Rescale-ReLU-SAT Path
(2 stage)

ReLU
128bit

Rescale
512bit

Stage 1，2

3unit
16 window per unit
（pipe → compute ）

16 unit
(3 sum + 1 bias per unit， 1 stage)

512bit

128bit

conv output: 512bit

bias

Stage 1

64bit

pipe

Stage 2

64bit

Stage 3

Bias: 64bit

SRAM w2
8x96bit

weight sram:
depth = 8
word width = 96

Param Store

weight: 288bit

bias sram:
depth = 8
word width = 64

SRAM w0
8x96bit

SRAM w1
8x96bit

SRAM b0
8x64bit

## Slide 50

SonicBolt Conv v2.5 架构分析

- conv 计算启动时序

外部使start=1，
start_buf_sel有效

issue_pos=0, issue_group=0

issue_pos=0, issue_group=1

issue_pos=0, issue_group=2

conv_core状态机

busy置1→req_inti_pos=1，pos_req_valid=1

Input_buffer

pos_row_data_bus加载工作集，window valid

conv_core状态机

conv_core状态机

stage0元数据有效(valid, pos, count, last)
issue_count 更新
issue_group, issue_pos
→更新地址，但是此时SRAM读的仍是之前地址
consume_tick有效

tile_mac 核心

第一拍，wire形式的输入数据/参数读入内部reg，与总线断开，输入元数据读入内部reg[0]

计算核心

数据
通
信时序

Input_buffer

active_buf_sel接收start_buf_sel

issue_fire仍为0, window valid后变为1

en信号有效，送出数据

conv_core状态机

输入元数据更新；pos-group更新

参数 SRAM

参数 SRAM

SRAM en信号=issue_fire，fire置1后有效

参数 SRAM

en信号有效，送出数据

## Slide 51

SonicBolt DWConv v1.0 架构分析

- dwconv 计算时序

issue_pos=0, issue_group=0

issue_pos=0, issue_group=1

计算核心

数据
通
信时序

fire = 0, issue_pos=0, issue_group = 0，计算核心待机

fire 信号变为有效，使得 SRAM 读使能信号有效

第一个tile有效，数据达到，然后接收到SRAM传来的参数，计算启动

第二个tile有效，数据达到，然后接收到SRAM传来的参数，计算启动

SRAM读地址更新

SRAM读地址更新

SRAM接收到使能信号以及addr，将数据送出

SRAM接收到使能信号以及addr，将数据送出

SRAM 无效

SRAM 无效

## Slide 52

SonicBolt Conv v2.5 架构分析

SRAM

reg

- conv_subsystem 架构电路图

Tile MAC
(4 stage)

Stage 1，2

11unit
64 window per unit
（pipe → compute ）

14x10x8bit

(14/12)x10x8bit

11x1216bit

64 unit
(11 sum + 1 bias per unit， 2 stage)

Stage 3, 4

Rescale-ReLU-SAT Path
(2 stage)

ReLU
512bit

Rescale
2048bit

Cache
(14x10x8bit)

1x10x8bit

prefetched
(2x10x8bit)

1120bit

2048bit

SRAM
(30x80bit)

pos_row_data_bus
(14x80bit)

MUX

64bit

512bit

bias

Stage 1

64bit

pipe

Stage 2

Input Buffer

weight sram:
depth = 8
word width = 224

SRAM w0
8x224bit

2464bit

SRAM w1
8x224bit

64bit

bias sram:
depth = 8
word width = 64

SRAM b0
8x64bit

Param Store

SRAM w2
8x224bit

······

SRAM w9
8x224bit

SRAM w10
8x224bit

## Slide 53

SonicBolt DWConv v1.0 架构分析

SRAM

reg

- dwconv_subsystem 架构电路图

Tile MAC
(3 stage)

3x288bit

Rescale-ReLU-SAT Path
(2 stage)

ReLU
128bit

Rescale
512bit

Stage 1，2

3unit
16 window per unit
（pipe → compute ）

16 unit
(3 sum + 1 bias per unit， 1 stage)

512bit

128bit

conv output: 512bit

bias

Stage 1

64bit

pipe

Stage 2

64bit

Stage 3

Bias: 64bit

SRAM w2
8x96bit

weight sram:
depth = 8
word width = 96

Param Store

weight: 288bit

bias sram:
depth = 8
word width = 64

SRAM w0
8x96bit

SRAM w1
8x96bit

SRAM b0
8x64bit

## Slide 54

SonicBolt PWConv v1.0 架构分析

ch0

data

s0 | s1 | s2 | s3

c0 | c1 | c3 | c3

s0 | s1 | s2 | s3

c0 | c1 | c3 | c3

ch1

s0 | s1 | s2 | s3

ch2

s0 | s1 | s2 | s3

ch3

index on spatial_idx

group0

……7

4 channels * 8

K0

K1

K2

K3

weight

c0 | c1 | c3 | c3

c0 | c1 | c3 | c3

index on out_idx

out0

group0

……7

4 channels * 8

out1

out2

out3

out

s0 | s1 | s2 | s3

s0 | s1 | s2 | s3

s0 | s1 | s2 | s3

s0 | s1 | s2 | s3

8 group of Partial sum(using current 4 channels of all kernels)

group0

……7

## Slide 55

SonicBolt PWConv v1.0 架构分析

out0

out1

out2

out3

ch0~3

s0 | s1 | s2 | s3

s0 | s1 | s2 | s3

s0 | s1 | s2 | s3

s0 | s1 | s2 | s3

group0

out0

out1

out2

out3

ch4~7

s0 | s1 | s2 | s3

s0 | s1 | s2 | s3

s0 | s1 | s2 | s3

s0 | s1 | s2 | s3

group1

……

out0

out1

out2

out3

ch28~31

s0 | s1 | s2 | s3

s0 | s1 | s2 | s3

s0 | s1 | s2 | s3

s0 | s1 | s2 | s3

group7

## Slide 56

SonicBolt PWConv v1.1 架构分析

SRAM

reg

- pwconv_subsystem 架构电路图

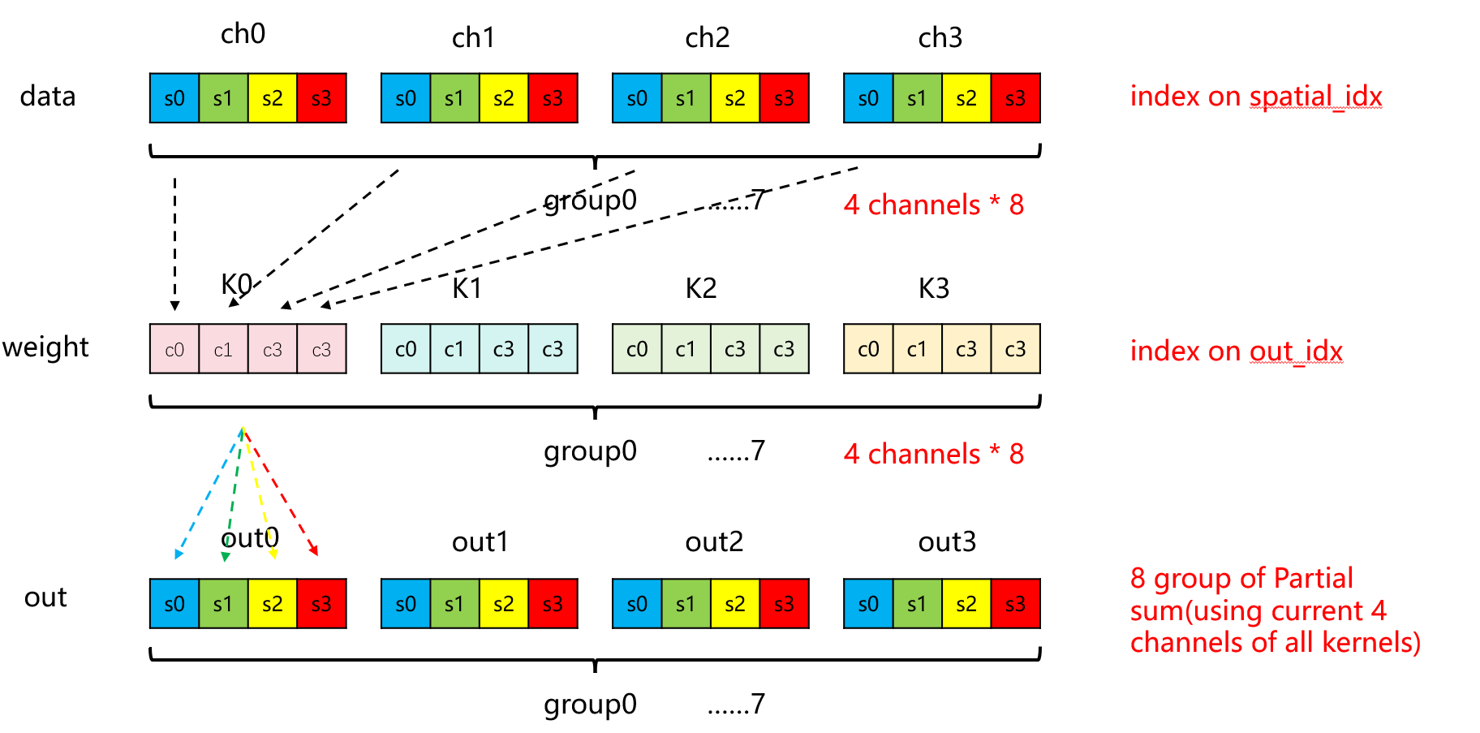
[picture p4: figure]
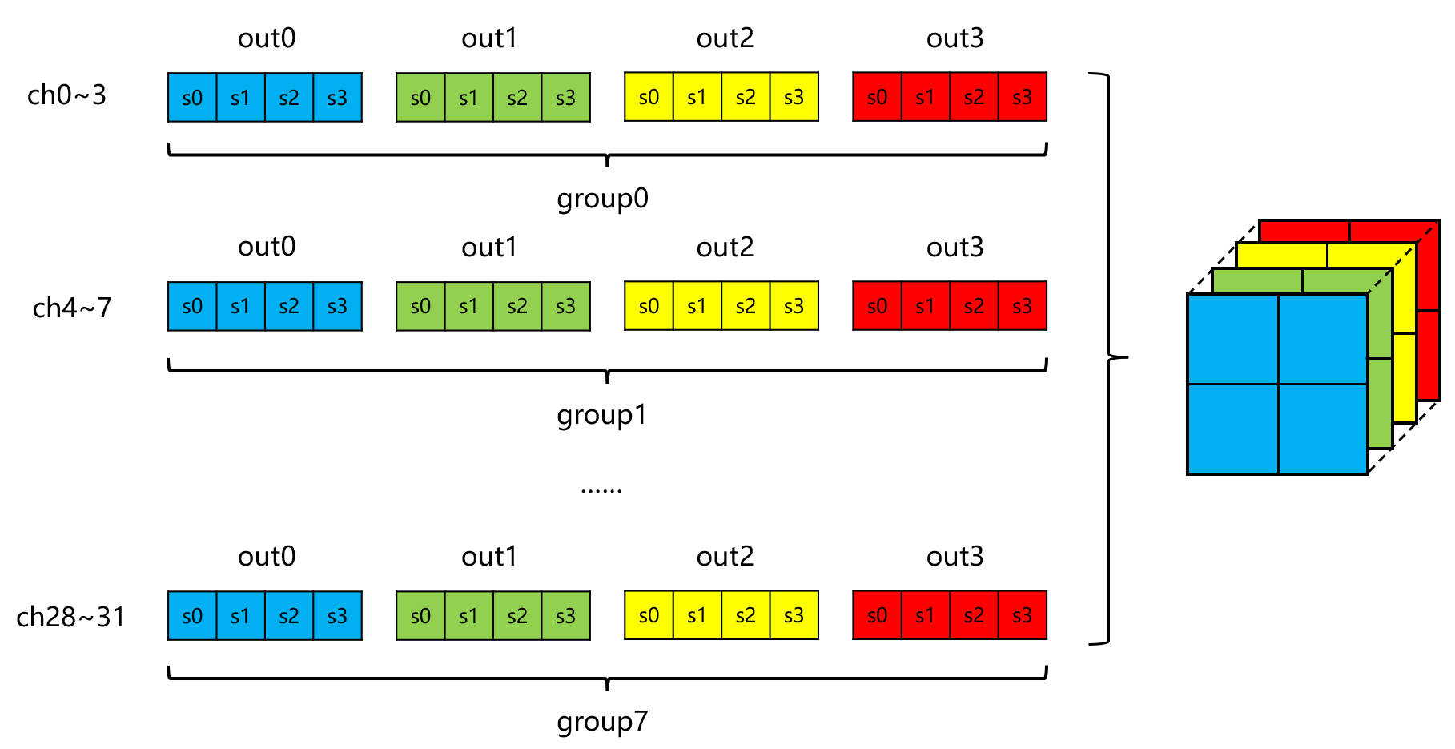
[picture p5: figure]

Tile MAC

weight

input

bisa

Stage 1

Rescale-ReLU-SAT Path
(2 stage)

ReLU
128bit

Rescale
512bit

pos%2

1024bit

8x4x4 unit
4 x mac per unit

内置8级隐藏流水

bias

Stage 2

128x18bit

4x4 unit
8 add per unit

bias

Stage 3

16x21bit

4x4 unit
bias add

Stage 4

dwconv output: 128bit

Even buffer
(1024bit)

1024bit

512bit

128bit

MUX

Odd buffer
(1024bit)

MUX

1024bit

64bit

64bit

64bit

weight sram:
depth = 8
word width = 128

SRAM w0
8x128bit

bias sram:
depth = 8
word width = 64

SRAM b0
8x64bit

weight: 1024bit

Bias: 64bit

SRAM w7
8x128bit

Param Store

SRAM w1
8x128bit

SRAM w2
8x128bit

······

## Slide 57

SonicBolt Conv v2.5 架构分析

SRAM

reg

- conv_subsystem 架构电路图

Tile MAC
(4 stage)

Stage 1，2

11unit
64 window per unit
（pipe → compute ）

14x10x8bit

(14/12)x10x8bit

11x1216bit

64 unit
(11 sum + 1 bias per unit， 2 stage)

Stage 3, 4

Rescale-ReLU-SAT Path
(2 stage)

ReLU
512bit

Rescale
2048bit

Cache
(14x10x8bit)

1x10x8bit

prefetched
(2x10x8bit)

1120bit

2048bit

SRAM
(30x80bit)

pos_row_data_bus
(14x80bit)

MUX

64bit

512bit

bias

Stage 1

64bit

pipe

Stage 2

Input Buffer

weight sram:
depth = 8
word width = 224

SRAM w0
8x224bit

2464bit

SRAM w1
8x224bit

64bit

bias sram:
depth = 8
word width = 64

SRAM b0
8x64bit

Param Store

SRAM w2
8x224bit

······

SRAM w9
8x224bit

SRAM w10
8x224bit

## Slide 58

SonicBolt DWConv v1.0 架构分析

SRAM

reg

- dwconv_subsystem 架构电路图

Tile MAC
(3 stage)

3x288bit

Rescale-ReLU-SAT Path
(2 stage)

ReLU
128bit

Rescale
512bit

Stage 1，2

3unit
16 window per unit
（pipe → compute ）

16 unit
(3 sum + 1 bias per unit， 1 stage)

512bit

128bit

conv output: 512bit

bias

Stage 1

64bit

pipe

Stage 2

64bit

Stage 3

Bias: 64bit

SRAM w2
8x96bit

weight sram:
depth = 8
word width = 96

Param Store

weight: 288bit

bias sram:
depth = 8
word width = 64

SRAM w0
8x96bit

SRAM w1
8x96bit

SRAM b0
8x64bit

## Slide 59

SonicBolt PWConv v1.1 架构分析

SRAM

reg

- pwconv_subsystem 架构电路图

Tile MAC

weight

input

bisa

Stage 1

Rescale-ReLU-SAT Path
(2 stage)

ReLU
128bit

Rescale
512bit

pos%2

1024bit

8x4x4 unit
4 x mac per unit

内置8级隐藏流水

bias

Stage 2

128x18bit

4x4 unit
8 add per unit

bias

Stage 3

16x21bit

4x4 unit
bias add

Stage 4

dwconv output: 128bit

Even buffer
(1024bit)

1024bit

512bit

128bit

MUX

Odd buffer
(1024bit)

MUX

1024bit

64bit

64bit

64bit

weight sram:
depth = 8
word width = 128

SRAM w0
8x128bit

bias sram:
depth = 8
word width = 64

SRAM b0
8x64bit

weight: 1024bit

Bias: 64bit

SRAM w7
8x128bit

Param Store

SRAM w1
8x128bit

SRAM w2
8x128bit

······

## Slide 60

SonicBolt Pose_Process v1.0 架构分析

- post process: frame accum

SRAM

reg

in_valid有效

in_last

······

计算核心

数据
通
信时序

accum_cls为0, accum_base_cls为0

sum_next_cls(wire)接收增量，frame_busy, 同时前一刻数据（此时为0）寄存给accum_cls

sum_next_cls(wire)接收增量，同时前一刻数据寄存给accum_cls

out_sum_cls从sum_next_cls收集结果，accum_cls置零，valid和last out信号置高

busy，accum_base_cls等于accum_cls

## Slide 61

SonicBolt Post Process v1.2 架构分析

SRAM

reg

- post_process 架构电路图

Computing Core

Rescale-SAT Path
(2 stage)

MacPool

2x2 window
MaxPool

Stage 1

FC MAC

4 unit
4xMAC per unit

Stage 2

FC Accum

72 cycle
FC accum add

Stage 3

4x8bit

2x32bit

2x32bit

2x32bit

2x8bit

2xFP32

pwconv output: 128bit

Rescale
512bit

ReLU
128bit

Sigmoid
LUT

weight sram:
depth = 72
word width = 64

Param Store

weight: 64bit

SRAM w0
72x64bit

Bias: 32bit

REG b0
2x16bit

Bias reg:
双路reg同时读写

## Slide 62

SonicBolt Conv v2.6 架构分析

SRAM

reg

- conv_subsystem 架构电路图

Tile MAC
(4 stage)

Stage 1，2

11unit
64 window per unit
（pipe → compute ）

14x10x8bit

(14/12)x10x8bit

11x1216bit

64 unit
(11 sum + 1 bias per unit， 2 stage)

Stage 3, 4

Rescale-ReLU-SAT Path
(2 stage)

ReLU
512bit

Rescale
2048bit

SRAM 0
(30x80bit)

1x10x8bit

Cache 0
(14x10x8bit)

1120bit

2048bit

1x10x8bit

SRAM 1
(30x80bit)

prefetched
(2x10x8bit)

pos_row_data_bus
(14x80bit)

MUX

64bit

512bit

Cache 1
(14x10x8bit)

bias

Stage 1

64bit

pipe

Stage 2

Input Buffer

weight sram:
depth = 8
word width = 224

SRAM w0
8x224bit

2464bit

SRAM w1
8x224bit

64bit

bias sram:
depth = 8
word width = 64

SRAM b0
8x64bit

Param Store

SRAM w2
8x224bit

······

SRAM w9
8x224bit

SRAM w10
8x224bit

## Slide 63

SonicBolt Conv v2.6 架构分析

SRAM

reg

- conv_shared_input_buffer 双帧缓存机制详解

选中该bank进行写入

commit

进入消费流，
变为active bank，
不再Ready

ping

写入流结束
Bank ready!

······

ping

ping

------ 写入流 ------

ping

ping

------ 消费流 ------

ping

······

选中该bank进行写入
进入新图写入流会话

pong

------ 写入流 ------

pong

pong

pong

pong

pong

变为写入bank
发送“写 ready信号”

伪 active bank

变为写入bank

## Slide 64

SonicBolt DWConv 架构分析

- dwconv_core 调度核心的有限状态机化设计

SRAM

reg

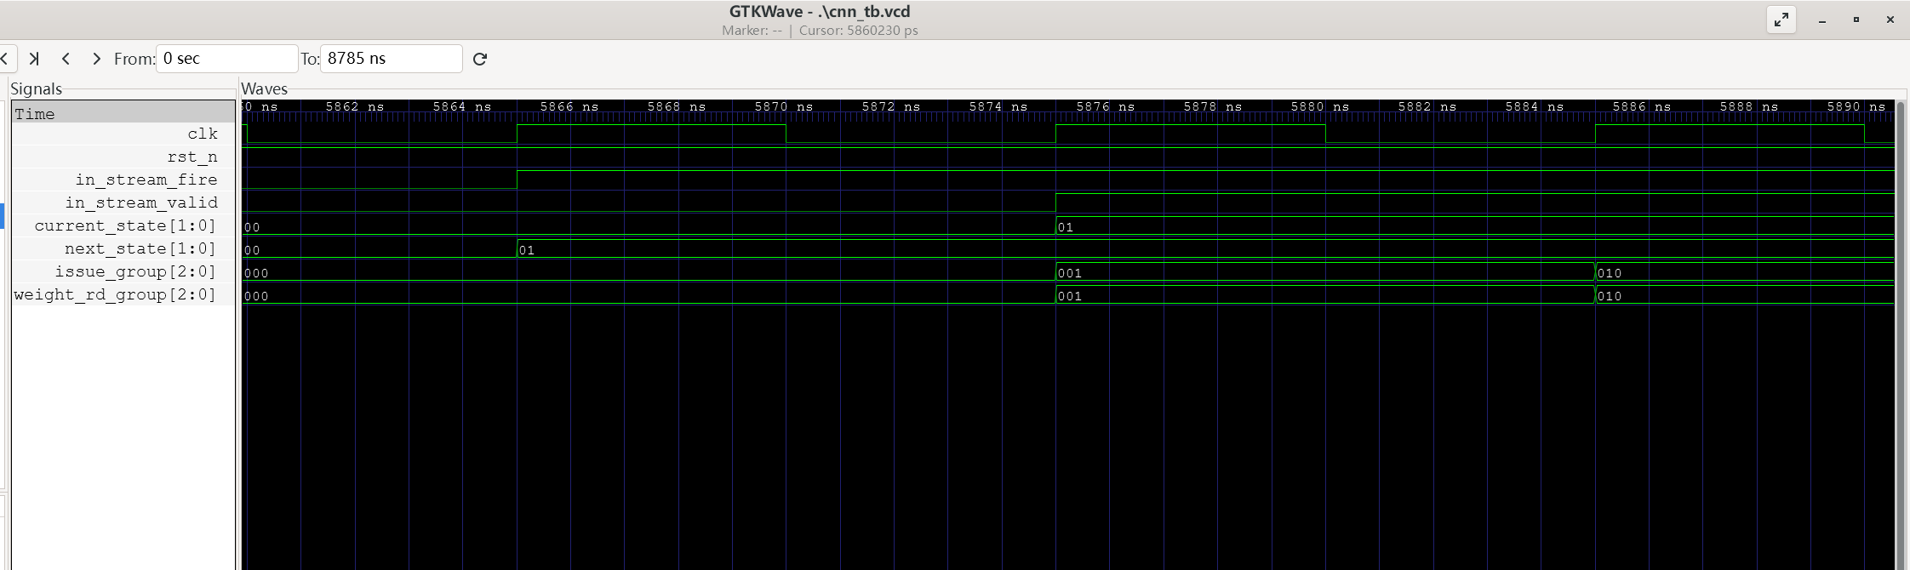
[picture p6: figure]

该周期SRAM使能信号有效，addr=0，下一个时钟周期准备读出第一个地址的权重

next_state=busy

输入数据仍然无效！同时SRAM正在给出addr=0的数据

此时采样时，current_state仍为旧值IDLE，issue_group必须等于1，以便下一个时钟上升沿SRAM读取addr=1的权重

第一个tile进入tile_mac打拍断开，SARM正在读addr=1的权重

## Slide 65

SonicBolt Conv v2.7 架构分析：半窗缓存

14

12

10

## Slide 66

SonicBolt Conv v2.6 架构分析

SRAM

reg

- conv_subsystem 架构电路图

Tile MAC
(4 stage)

Stage 1，2

11unit
32 window per unit
（pipe → compute ）

14x10x8bit

(14/12)x10x8bit

11x608bit

32 unit
(11 sum + 1 bias per unit， 2 stage)

Stage 3, 4

Rescale-ReLU-SAT Path
(2 stage)

ReLU
512bit

Rescale
2048bit

Half window cache
32 x 2 x 4 x 8 bits

SRAM 0
(30x80bit)

1x10x8bit

Cache 0
(14x10x8bit)

1120bit

1024bit

256bit

1x10x8bit

SRAM 1
(30x80bit)

prefetched
(2x10x8bit)

pos_row_data_bus
(14x80bit)

MUX

64bit

Cache 1
(14x10x8bit)

bias

Stage 1

64bit

pipe

Stage 2

Input Buffer

512bit

weight sram:
depth = 8
word width = 224

SRAM w0
8x224bit

2464bit

SRAM w1
8x224bit

64bit

bias sram:
depth = 8
word width = 64

SRAM b0
8x64bit

Param Store

SRAM w2
8x224bit

······

SRAM w9
8x224bit

SRAM w10
8x224bit

## Slide 67

SRAM 0
(30x80bit)

1x10x8bit

(14/12)x10x8bit

Cache 0
(14x10x8bit)

14x10x8bit

SRAM(22x(32x112bit) + 1x(32x64bit))

Tile MAC (7 stage)

Half tile cache
32 x 2 x 4 x 8 bits

Rescale-ReLU-SAT (2stage)

256bit

256bit

concat

1x10x8bit

prefetched
(2x10x8bit)

MUX

输出寄存

1120bit

输入打拍

乘法

11x608bit

行归约

列归约

1024bit

重量化

激活

512bit

SRAM 1
(30x80bit)

Cache 1
(14x10x8bit)

Input Buffer

Stage 1

Stage 2

Stage 3, 4

Stage 5,6,7

Stage 8

Stage 9

SRAM(3x(32x96bit) + 1x(32x64bit))

Tile MAC (4 stage)

行归约

pos%2

PWConv Input Buffer (9 stage)

SRAM(8x(32x128bit) + 1x(32x64bit))

Tile MAC (6 stage)

输入打拍

乘法

列归约

Rescale-ReLU-SAT (2stage)

重量化

激活

Even buffer
(1024bit)

输入打拍

乘法

四级
归约

3x192bit

Stage 3

512bit

128bit

MUX

Odd buffer
(1024bit)

MUX

Stage 1

Stage 2

Stage 4

Stage 5

Stage 6

Stage 1

Stage 2

Stage 3,4,5,6

Rescale-ReLU-SAT (2stage)

重量化

激活

Computing Core (4 stage)

最大池化

SRAM
（72x64）

局部累加

全局累加

Rescale-ReLU-SAT (2stage)

重量化

饱和截断

2xFP32

乘法

Sigmoid
LUT

Sigmoid LUT (2stage)

Stage 7

Stage 8

Stage 1

Stage 2

Stage 3

Stage 4

Stage 5

Stage 6
