SmlCoke/2026-MST3314-SonicBolt/SonicBolt/docs/figures-yxl-m.pptx

## 系统级

助教代码框架梳理

CNN_top.v

计算

处理

量化

算子级

SA1.v SA_2.v SA_3.v卷积

maxpool_v2.v relu.v SigLUT.v

rescale_*.v

单元级 寄存器、储存器

## Slide 2

Conv1重复计算分析

问题：
8/16重复
解决：
line buffer（老办法，寄存器多）
输出驻留（①16组乘单元编号，让某些号的计算结果留在计算单元里——下一次直接复用，依赖于乘法单元的位置的对应②16组乘法单元再分上下两组，下组只在第一次中需要计算）

卷积核

重复12行

乘法单元

## Slide 3

Conv1总线、扇出大

问题：
数据总线大
解决：
line buffer（16×10×8大小0.16KB）第一次读14×10×8（或者分2周期读，一次560bits），后面八次读进来后两行再换序（整体往上挪2），这样读的数少了，总线降下来了。（需要换序，不然太乱了，但是换序需要一个周期？每张图多一个周期？考虑并在流水里的话这两个周期可以省去（比如第一张图的后两个周期开始读后两行+换序））
原方案为9个1×14×10串行，改位流水，如右图。
是否考虑品乓缓存/第二张图在第二个周期开始读

32

1

1

1

4

line buffer

9

32×9×1➗ 4×1×1=72周期

## Slide 4

Stage 1: 将7 个 8bit 乘法结果sign‑extend 到 32bit，CSA Tree 做压缩，把 7 个数压到2个“部分和”sum&carry

Conv1 77个乘累加的三级流水计算量不匹配

Stage 2: 分组8+8+7（含bias）进行CSA求和

Stage 3: 6个32bit数求和，再进行CPA求和

问题：
第一级 7个8bit累加
第二级 六组2个32bit加
第三级 一组6个32bit加
解决：
两层并行CSA+一次CPA
CSA让传播进位只发生一次
sign-extend的意义（需要吗）
保证符号位
不会溢出

sum&carry

sum&carry

sum&carry

sum&carry

sum&carry

sum&carry

sum&carry

sum&carry

sum&carry

sum&carry

sum&carry->CPA

sum&carry

sum&carry

sum&carry

sum&carry

bias

## Slide 5

Conv1问题1

问题：
构架先将一张特征图30×10×8的数据存入寄存器，再由pos指路截取14×10×8的数据以及卷积核11×7×8的数据送入64（ch(4) x oy(4) x ox(4)）个计算单元中对应的计算单元，这个过程涉及到大量的布局布线，会占用大量的面积
加一级流水寄存器，通过分段——总线，寄存器，11个乘加，短线简单长线难

## Slide 6

Conv1问题2

问题：
输入30×10×8bit太大了，目前：两份整帧双缓冲 cache frame_cache0 和 frame_cache1（一行80bit按照乒乓缓存输入），它们分别对应系统语义上的：ping和pong
解决：
再慢可以再加流水输入

## 待做

- 写CNN_chip.v例化接口（pad）

## Slide 8

PWconv_conv_core分析

start = 1开始
in_stream_valid = 1

busy置1
recv_count置0
issue_count置0
issue_pos置0 stage0_valid置0
stage0_last置0
stage0_pos置0
stage0_group置0
in_stream_ready = 1
input_fire = 1

recv_count = 1
loaded_pos_count = 1
issue_fire = 1（有库存且总发射小于总数）

stage0_valid = 1
issue_count = 1
issue_group 和 issue_pos 由issue_count 计算得到

in_stream_valid

核心——发射至MAC的时机
issue_fire = busy && (issue_count < TOKEN_COUNT) && (issue_pos < loaded_pos_count)

仓库有多余pos级为发射且总发射pos未满

## Slide 9

PWconv_param_store分析

核心：并行度在 bank 维，便于一拍出数据

bank0:4输入通道

对应一个输入token

bank0

4×4×8=128bit

addr0:
4输出通道

bank1

bank_bias

4×16=64bit

addr0

addr1

并行度在 bank 维

addr2

addr：0~7
depth=8

addr3

addr4

addr5

addr6

addr7

bank：0~7 8个sram

## Slide 10

PWconv_conv_core分析

下一批，Weight根据更新后的stage0_bank取数据，data也是，然后一起进入第一级流水

start = 1开始
in_stream_valid = 1

busy置1
recv_count置0
issue_count置0
issue_pos置0 stage0_valid置0
stage0_last置0
stage0_pos置0
stage0_group置0
in_stream_ready = 1
input_fire = 1

recv_count = 1
loaded_pos_count = 1
issue_fire = 1（有库存且总发射小于总数）

issue_fire拉高后，sram读信号有效

检测到issue_fire为高，stage0元数据组获取第一个tile，于此同时输入数据根据stage_pos[0]截取正确group，与权重和偏置一起进入第一级流水。

issue_bank更新

in_stream_valid

核心——发射至MAC的时机
issue_fire = busy && (issue_count < TOKEN_COUNT) && (issue_pos < loaded_pos_count)

仓库有多余pos级为发射且总发射pos未满
