SmlCoke/2026-MST3314-SonicBolt/Notes/input_ping_pong_notes.md

这几行逻辑里，**你的两个担心都很合理**，但结论是：

- 你担心的 `(1)` 里“active bank 被立刻覆盖”这件事，**按当前表达式本身不会发生**
- 你担心的 `(2)` 里“为什么新图默认写 `~active_bank`”，**在当前这套双 bank 假设下是对的**
- 不过有一处地方确实容易让人误解：**注释写得不准确，容易把 `ready_bank_mask` 和 `img_wr_ready` 的作用混在一起**

我拆开讲。

---

## 1. 先明确这几个信号各自表示什么

### `ready_bank_mask`
表示：

- 哪个 bank 里已经有一张**完整写完、可被启动消费**的图

它不是“bank 是否空闲”，而是“bank 是否已经装好待计算数据”。

所以：

- `ready = 1`：这个 bank 里有一张已经写完的图，随时可以 `start_consume`
- `ready = 0`：这个 bank 当前没有“待消费整帧”

---

### `active_bank`
表示：

- 当前 **Conv 正在读哪个 bank**

---

### `img_wr_ready`
表示：

- **现在是否允许外部继续写一张新图**

它不是“当前 active bank 是否安全”，而是：

- “当前有没有一个 bank 可供写入新图”

---

### `selected_write_bank`
表示：

- **这一拍如果真的接受写入，那写到哪个 bank**

---

## 2. 你担心的第一个问题：`start_consume` 后 `img_wr_ready` 会不会立刻变高，导致 active bank 被写坏？

你引用的是这段：

```verilog
assign img_wr_ready = write_inflight || !ready_bank_mask[~active_bank];
```

还有：

```verilog
if (start_consume) begin
    active_bank <= consume_bank_sel;
    ready_bank_mask[consume_bank_sel] <= 1'b0;
end
```

你的担心是：

- 当前 bank 一进入消费，就把 `ready_bank_mask` 清 0
- 那 `img_wr_ready` 会不会立刻变高
- 外部一看到高，就开始写
- 把正在读的 active bank 写坏

### 结论：**不会因为这句而写坏 active bank**

关键点在这句：

```verilog
img_wr_ready = write_inflight || !ready_bank_mask[~active_bank];
```

注意它看的不是：

- `ready_bank_mask[active_bank]`

而是：

- `ready_bank_mask[~active_bank]`

也就是 **active 的对侧 bank**。

---

### 举个例子

假设现在：

- `consume_bank_sel = 0`
- 所以 `active_bank` 会变成 `0`

那么：

```verilog
img_wr_ready = write_inflight || !ready_bank_mask[1];
```

它检查的是 **bank1 能不能写**，不是 bank0。

所以即使你在 `start_consume` 时把：

```verilog
ready_bank_mask[0] <= 1'b0;
```

清掉了 bank0 的 ready，

`img_wr_ready` 也不会因为 bank0 被清零而变化，它只看 bank1。

---

### 为什么这在结构上是安全的

因为你的设计本来就是：

- `active_bank`：只负责读
- `~active_bank`：只负责准备下一张图写入

所以只要写入目标始终是 `~active_bank`，就不会破坏当前消费 bank。

---

### 你提到“难道不应该等 active bank 最后两行预取成功后再允许写吗？”

**不需要。**

因为“最后两行预取”也是从：

- `active_bank`

读出来的。

而你允许外部写的是：

- `~active_bank`

这是另一个 bank，物理上就是另一块 SRAM。

所以：

- active bank 里的工作集滑窗 / 两行预取
- 和 non-active bank 上写下一张图

这两件事是可以并行的。

换句话说：

**你要等的是“non-active bank 可不可写”，不是“active bank 读完没读完”。**

---

## 3. 你担心的第二个问题：为什么新图刚开始写时，默认 `selected_write_bank = ~active_bank`？

你引用的是：

```verilog
assign selected_write_bank = write_inflight ? write_bank : ~active_bank;
```

你的疑问是：

- 为什么不在写入流时就默认写 `~active_bank`
- 这个一定成立吗？

### 结论：**在当前双 bank 设计下，这是对的**

因为当前系统只有两个 bank：

- 一个 active，正在被消费
- 另一个 non-active，是唯一可能安全写入的 bank

所以当：

- 当前不在写入流里
- 又准备开始写一张新图

那么新图只能写到：

```verilog
~active_bank
```

没有第三个选择。

---

### 为什么还要保留 `write_inflight ? write_bank : ~active_bank`

因为一张图有 30 行，不是 1 行。

你必须保证：

- 第 0 行写到哪个 bank
- 第 1~29 行也必须继续写同一个 bank

所以：

- `write_inflight = 0` 时：说明要开始一张新图，选 `~active_bank`
- `write_inflight = 1` 时：说明正在写同一张图，必须继续写 `write_bank`

这是为了保证“整张图的 30 行都写到同一个 bank”。

---

## 4. 这段逻辑成立的前提是什么

这套逻辑成立，有一个很重要的前提：

**外部只能在 `img_wr_ready = 1` 时开始一张新图写入。**

也就是：

- 没有 `img_wr_ready`
- 或者你无视它硬写

那当然可能写坏协议。

所以这里实际上默认系统行为是：

1. 外部先看 `img_wr_ready`
2. 只有 ready 才开始从 `addr=0` 写一整帧
3. 写完后再 `img_wr_commit`

在这个前提下：

```verilog
selected_write_bank = ~active_bank
```

是合理的。

---

## 5. 真正值得你警惕的不是这两句，而是这句注释

你写的这句注释：

```verilog
// 当前 bank 进入消费流后，判定其为 ready
ready_bank_mask[consume_bank_sel] <= 1'b0;
```

这个注释其实是反的。

应该理解成：

- 当前 bank 一进入消费流，就**不再属于“待消费 ready bank”**
- 所以把它的 `ready` 清 0

更准确的注释应该是：

```verilog
// 当前 bank 已被选中进入消费流，不再属于“待启动消费”的 ready bank
ready_bank_mask[consume_bank_sel] <= 1'b0;
```

这一点很关键，不然会把“ready”误解成“可用/空闲”。

---

## 6. 所以这两段逻辑到底是不是错的？

### 不是错的部分
这两句本身的核心思想是对的：

```verilog
assign img_wr_ready        = write_inflight || !ready_bank_mask[~active_bank];
assign selected_write_bank = write_inflight ? write_bank : ~active_bank;
```

它们表达的是：

- 如果当前已经在写一张图，那当然继续允许写
- 如果当前没在写，那只有当 non-active bank 还没有装好待消费图时，才允许开始写新图
- 新图一旦开始写，就写到 non-active bank

这套逻辑是成立的。

---

### 你现在更需要注意的点
不是这两句，而是系统层面要保证：

1. `start_consume` 只能在 `ready_bank_mask != 0` 时发生
2. 外部只能在 `img_wr_ready = 1` 时开始一张新图
3. 新图写入必须按 `addr=0..29` 连续完成
4. `img_wr_commit` 必须只在当前写会话结束时打一拍

---

## 7. 一句话总结

你的两个疑问里：

- `(1)` **不会写坏 active bank**，因为 `img_wr_ready` 和 `selected_write_bank` 都是围绕 `~active_bank` 在工作，不是围绕 active bank
- `(2)` **新图默认写 `~active_bank` 是正确的**，因为双 bank 结构下，除了正在消费的 bank，另一个 bank 就是唯一合法写入目标

真正需要改的不是这两句逻辑本身，而是：
- 把 `ready_bank_mask[consume_bank_sel] <= 1'b0;` 旁边的注释改准确
- 确保顶层严格遵守 `img_wr_ready / img_wr_commit / start` 这套时序协议

如果你愿意，我下一步可以直接帮你把这几句附近的注释改成“不会误导”的版本。
