SmlCoke/2026-MST3314-SonicBolt/Demo/demo3-claude-opus/片上缓存.md

这份代码极其有价值！你找到了一份纯正的**工业级 EDA 工具（Synopsys Memory Compiler）自动生成的 SRAM 仿真模型**，以及上一届学长对它的“魔改”包装。

这解开了你之前对“片上缓存到底长啥样”的全部疑惑。

我们来深度剖析一下这位学长的做法，看看他**做对了什么**，以及**为什么你不能完全照搬他的做法**（因为你们的性能目标不同）。

---

### 一、 这段代码到底是什么？（揭开 SRAM 的真面目）

#### 1. 前半部分：`asdrlspkb...` 模块
这根本不是学长手写的，这是用 **Synopsys 的内存编译器 (Memory Compiler)** 输入参数（比如 32个词，每个词32位）后，工具**自动生成的 Verilog 行为级模型 (Behavioral Model)**。
*   **为什么要有这个文件？** 因为真实的 SRAM 是由底层的模拟电路（6T 晶体管交叉耦合）构成的，ModelSim 这种纯数字仿真器根本看不懂模拟版图。所以 EDA 工具生成了这个带有 `always @(posedge CLK)` 和大量报错机制（如 `report_unknown`）的 Verilog 文件，仅仅是为了让你**能跑仿真**。
*   **后端的真相**：在第 6 周跑 DC 综合和第 7 周跑 ICC 物理版图时，综合工具会**直接扔掉这个 Verilog 文件**，替换成物理工艺库里真实的 SRAM 硬核（Hard Macro，黑盒子）。

#### 2. 后半部分：学长手写的 `Conv_WeightSelector`
学长做了一个极其聪明的**“SRAM 拼接操作”**：
*   他需要一次性读出一个完整的卷积核（$11 \times 7 = 77$ 个权重，每个 8 bit，共 **616 bit**）。
*   但是 TA 提供的单块 SRAM 可能无法支持 616 bit 这么宽的数据接口。
*   于是，他**把 8 块宽度为 77-bit 的 SRAM 并联了起来**（通过给同样的地址 `ADR`，同时使能 `ME`）。
*   $8 \times 77 \text{ bit} = \mathbf{616 \text{ bit}}$。这样，他就能在一个时钟周期内，完美读出 1 个卷积核的全部参数！

---

### 二、 你应该这么做吗？

**结论：你需要学习他的“SRAM 实例化”方法，但绝对不能采用他的“架构连线”方法！**

#### 为什么不能照搬他的架构？（性能维度的降维打击）
学长的架构是：**1 拍读出 1 个卷积核（616 bit），送给 1 棵 MAC 树进行计算。**
这意味着，他一个周期只能计算 **1 个输出通道**。
你们的 Conv1 有 32 个输出通道，用学长的方法，算完空间上的 1 个像素，需要跑 **32 拍**！
加上滑动整个图像的时间，学长处理一帧图像大概需要 $32 \times 80 = \mathbf{2560 \text{ 拍}}$。

而你在上一轮定下的“1000K FPS 高性能架构”指标是：**要求 150 拍以内算完一帧！**
如果你要在一个周期内算完 32 个通道，你需要同时拥有 32 个卷积核的数据，即 $32 \times 616 = \mathbf{19712 \text{ bit}}$ 的带宽！
**没有任何片上 SRAM 能在一个周期内吐出将近 2 万 bit 的数据，强行并联几十个 SRAM 会导致芯片布线彻底爆炸，面积直接超标。**

---

### 三、 你的“高性能”终极正确做法（L2 SRAM + L1 寄存器）

这就是我们上一轮讨论的**“权重驻留（Weight Stationary）”**架构的落地实操。

**你的 SRAM 不应该像学长那样直接连着 MAC 树（计算单元），而是应该连着你之前觉得“很费面积”的 `weight_reg` 数组！**

#### 你的正确工作流如下：

**1. 准备 SRAM（L2 仓库）**
*   去查看 TA 今年到底给你们提供了什么规格的 SRAM 模型（比如是 `宽度 32-bit × 深度 1024` 的标准 SRAM）。
*   把所有网络的权重，预先写在文件里，通过这个 SRAM 读入。

**2. 设计 `LOAD_WEIGHT` 状态机（蚂蚁搬家）**
*   在芯片刚开机时（`FSM = LOAD_WEIGHT`），MAC 计算阵列处于**断电休眠状态**。
*   你通过状态机，一拍一拍地给 TA 提供的单端口 SRAM 发地址。
*   SRAM 每拍吐出 32 bit 数据，你就把这 32 bit 存进内部的 `weight_reg` 阵列里。
*   经过几百个周期，你把 19712 bit 的权重，全部从 SRAM “搬运”到了 MAC 阵列内部的 32 组 `weight_reg` 中。

**3. 切换 `CALC_RUN` 状态（核弹点火）**
*   权重搬运完毕，SRAM 可以去干别的事了（比如去读输入特征图）。
*   此时 MAC 阵列启动！因为 19712 bit 的权重已经**零距离贴在乘法器旁边（在 D 触发器里）**，它们提供了**无限的并行读带宽**！
*   MAC 树全火力输出，1 拍算完 32 通道，80 拍轰完第一层卷积，轻松达成 1000K FPS！

---

### 四、 总结与给你的行动建议

学长的代码证明了：**课程最终必须要使用底层的 SRAM 宏模块。**

所以，你现在的规划非常清晰了：
1.  **AI 写的样板代码里的 `weight_reg` 阵列，你不仅要保留，还要大方地用。** 对于高性能架构，这是合理的空间换时间。
2.  **你需要向 AI 补充一点提示：** “请在顶层模块中，保留 `reg [7:0] weight_reg [0:31][0:76]` 的定义，并在 `LOAD_WEIGHT` 状态中，设计一个从 **32-bit 单端口外部 SRAM** 逐周期读取数据并填满这个巨大 reg 阵列的逻辑。”
3.  **找 TA 确认：** 赶紧看看你们课程下发的资料包，TA 提供的 SRAM 模型位宽是多少（8位？32位？还是像学长那样允许你们用软件自己生成 77位的？）。这点确认清楚后，你们的接口连线就彻底锁定了。

放手让 Claude Code 去生成吧，配合上面的修改，它生成的将是一份能够直接秒杀全场的高性能架构代码！
