SmlCoke/2026-MST3314-SonicBolt/Notes/slices/hint.md

# Hint

## Lecture 2 

频率: 100M~120M
7×11阵列，滑窗移动到最右侧时，下一次移动到哪？移动到下一行最左侧时数据无法复用，移动到最右侧可以复用。
32通道同时计算，否则有效贷款只有1/32。如果发现性能太高，可以降低规模
Ping-Pong模式，一个feature map处理时，下一个feature map的数据正在写入memory，减少等待时间。
单通道处理的话：filter 的权重也可做类似处理，reg1存当前通道，reg2存下一通道，计算时reg1，计算完切换到reg2，reg1更新为下一通道权重；32通道并行的话，也有类似问题。
上述发生的同时，下一级DWConv的输入数据在哪？可以缓存在片上，也可以放在片外，一般数据量不大可以放在片上。输入数据的顺序可能不是MAC阵列输出的顺序，需要重新排列。
注意：SRAM 单端口，可读可写，但不能同时读写。
SRAM 存储电路只占一小部分、如果采用分布式（例如7个，每个存储基本单元是8bit），面积会很大。采用一个整体面积会小很多，但是地址计算会复杂。如果采用一维？
