SmlCoke/2026-MST3314-SonicBolt/Demo/demo3-claude-opus/Archi-analysis.pdf

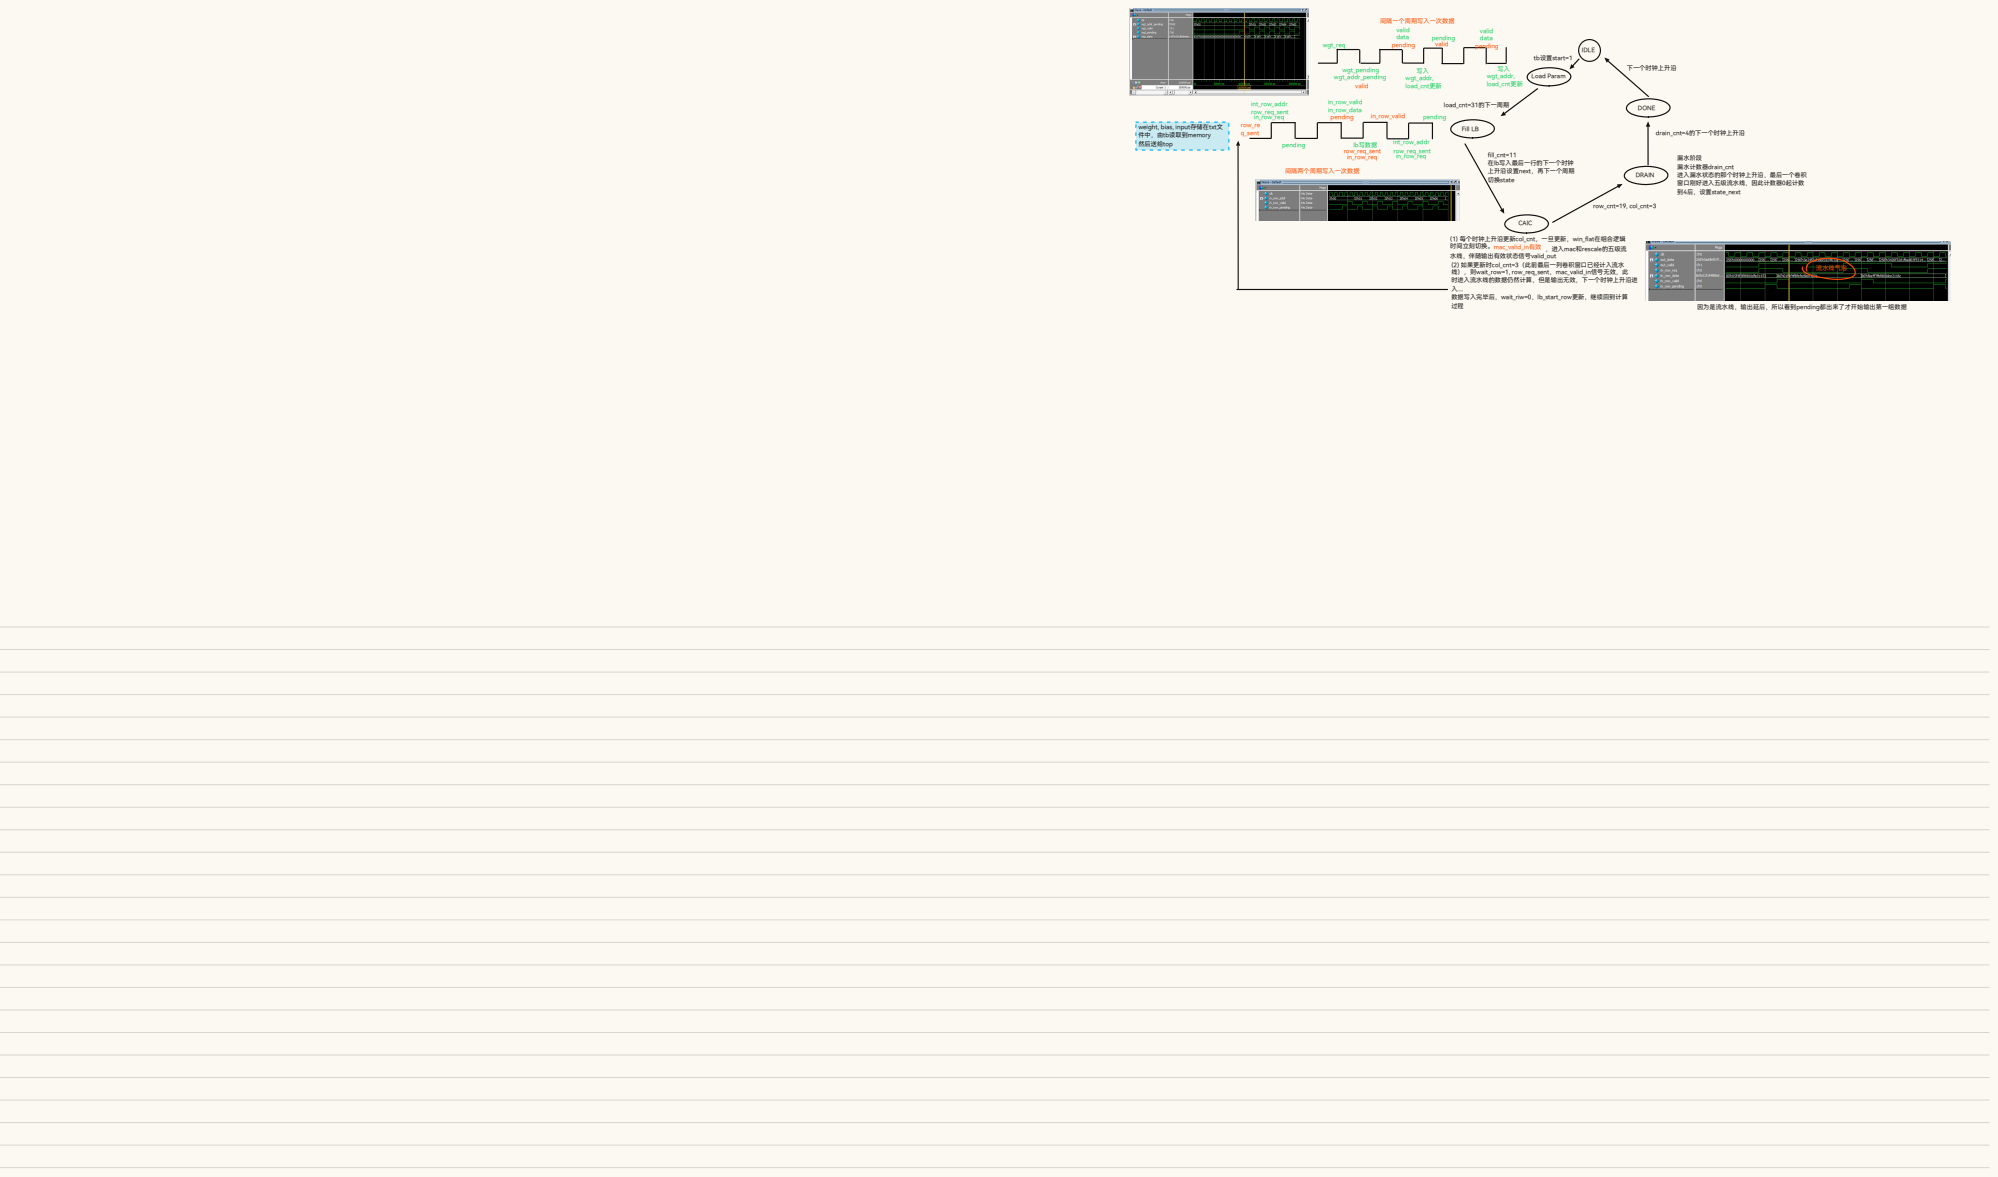
[picture p13: page 1]
IDLE; tb设置start=1; Load Param; wgt_req; wgt_pending wgt_addr_pending; valid data pending; pending; valid; wgt_addr, load_cnt更新; 间隔一个周期写入一次数据; load_cnt=31的下一周期; Fill LB; row_re q_sent; int_row_addr row_req_sent in_row_req; in_row_valid in_row_data pending; lb写数据 row_req_sent; in_row_valid; row_req_sent; int_row_addr; in_row_req; 间隔两个周期写入一次数据; CAlC; fill_cnt=11 在lb写入最后一行的下一个时钟 上升沿设置next，再下一个周期 切换state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

weight, bias, input存储在txt文
件中，由tb读取到memory
然后送给top
