SmlCoke/2026-MST3314-SonicBolt/SonicBolt/src/conv/conv_tile_mac.v

`timescale 1ns / 1ps
/*
 * 模块名称: conv_tile_mac
 * 作者: SonicBolt 团队
 * 日期: 2026-04-12
 * 版本: v2.4
 *
 * 功能概述:
 *   计算一个 {pos, group} token 对应的 Conv1 半窗结果。
 *   当前版本不再直接输出完整 4x4 tile，而是输出 4ch x 2x4 的 INT32 半窗，
 *   供 conv_core 在下一次相邻 pos 到来时做寄存复用与拼接。
 *
 * 位宽说明:
 *   - pos_window_data : 14(row) x 10(col) x 8bit = 1120bit
 *   - weight_data_bus : 11(row) x 4(ch) x 7(col) x 8bit = 2464bit
 *   - bias_data_bus   : 4(ch) x 16bit = 64bit
 *   - out_accum_bus   : 4(ch) x 2(row) x 4(col) x 32bit = 1024bit
 *
 * 索引规则:
 *   - 输入窗口像素:
 *       in_idx = row * 10 + col
 *   - 权重:
 *       weight_idx = ch * 11 * 7 + row * 7 + col
 *   - 输出:
 *       out_idx = ch * 8 + oy * 2 + ox
 *
 * 版本定位:
 *   - v2.0 中，本模块不再在单个 always 中直接完成 77 次 MAC。本模块主要负责流水级拼接，具体计算下沉到子模块。
 *      - 当前流水拆分为: input_stage + 11 个 row_mult + row_reduce_row_add
 *   - v2.1 中，将 input_stage 中数据与权重的打拍下沉到子模块内部，撤销长布线拉扯。此外，将 row_add 由一级流水*     拆分为两级，期望改善布线压力，降低时序拥堵。
 *   - v2.2 相比 v2.1 增加了第二层启动信号 out_stream_fire，当该信号为高时，告诉第二层 SRAM: 
 *     "马上开始准备参数, 下一个周期就要开始计算了"
 *   - v2.3 将所有公共子模块提取（例如bias_pipe, meta_pipe）到 utils/ 目录下
 *   - v2.4 实现了半窗缓存，将 INT8 乘法器数量从 4928 砍到 2464，期望减小逻辑综合优化难度，减少综合时间
 */
module conv_tile_mac (
    input  wire                clk,             // 时钟
    input  wire                rst_n,           // 低有效复位

    // ---------- 输入元数据 ----------
    input  wire                in_valid,        // 当前 token 有效
    input  wire                in_last,         // 当前 token 是否为整帧最后一个 token
    input  wire [3:0]          in_pos,          // 当前 token 的 pos 编号，范围 0~9
    input  wire [2:0]          in_group,        // 当前 token 的 group 编号，范围 0~7
    input  wire                in_fire,         // 通知第二层准备参数

    // ---------- 输入数据 ----------
    input  wire [14*10*8-1:0]  pos_window_data, // 14x10x8bit 输入窗口
    input  wire [11*4*7*8-1:0] weight_data_bus, // 当前 group 的完整 11x4x7 INT8 权重
    input  wire [4*16-1:0]     bias_data_bus,   // 当前 group 的完整 4 个 INT16 偏置

    // ---------- 输出元数据 ----------
    output wire                out_valid,       // 输出累加半窗有效
    output wire                out_last,        // 输出累加半窗是否为最后一个 token
    output wire [3:0]          out_pos,         // 输出半窗的 pos
    output wire [2:0]          out_group,       // 输出半窗的 group
    output wire                out_fire,        // 输出的第二层启动信号

    // ---------- 输出数据 ----------
    output wire [4*2*4*32-1:0] out_accum_bus    // 4(ch) x 2(row) x 4(col) x INT32
);
    // ---------- stage1: 元数据 / 偏置打拍 ----------
    wire [4*16-1:0] stage1_bias_bus;      // stage1 out: 寄存器打一拍后的偏置总线        
    wire            stage1_valid;         // stage1 out: 打一拍后的 valid       
    wire            stage1_last;          // stage1 out: 打一拍后的 last      
    wire [3:0]      stage1_pos;           // stage1 out: 打一拍后的 pos     
    wire [2:0]      stage1_group;         // stage1 out: 打一拍后的 group       
    wire            stage1_fire;          // stage1 out: 打一拍后的 fire      

    // ---------- stage2: 11 个 row_mult 并行部分和 ----------
    // 4ch x 2row x 4col x 19bit
    wire [4*2*4*19-1:0]    row_sum_bus_0;
    wire [4*2*4*19-1:0]    row_sum_bus_1;
    wire [4*2*4*19-1:0]    row_sum_bus_2;
    wire [4*2*4*19-1:0]    row_sum_bus_3;
    wire [4*2*4*19-1:0]    row_sum_bus_4;
    wire [4*2*4*19-1:0]    row_sum_bus_5;
    wire [4*2*4*19-1:0]    row_sum_bus_6;
    wire [4*2*4*19-1:0]    row_sum_bus_7;
    wire [4*2*4*19-1:0]    row_sum_bus_8;
    wire [4*2*4*19-1:0]    row_sum_bus_9;
    wire [4*2*4*19-1:0]    row_sum_bus_10;

    // stage2_row_sum_bus 是连线关系，无组合逻辑开销
    wire [11*4*2*4*19-1:0] stage2_row_sum_bus;

    // stage2: 偏置和元数据打拍结果
    wire [63:0]            stage2_bias_bus;
    wire                   stage2_valid;
    wire                   stage2_last;
    wire [3:0]             stage2_pos;
    wire [2:0]             stage2_group;
    wire                   stage2_fire;

    // ---------- stage3 / stage4: row_add 两级归约 ----------
    wire       stage3_valid;
    wire       stage3_last;
    wire [3:0] stage3_pos;
    wire [2:0] stage3_group;
    wire       stage3_fire;

    wire       stage4_valid;
    wire       stage4_last;
    wire [3:0] stage4_pos;
    wire [2:0] stage4_group;
    wire       stage4_fire;


    // ---------------------------------------------------------------------
    // ------------------------- 第一级流水：stage1 --------------------------
    // - 偏置和元数据打拍，数据与权重打拍已下沉
    // ---------------------------------------------------------------------

    // stage1: 偏置与元数据打一拍。
    bias_pipe u_bias_pipe_stage1 (
        .clk(clk),
        .rst_n(rst_n),
        .in_bias_bus(bias_data_bus),
        .out_bias_bus(stage1_bias_bus)
    );

    meta_pipe u_meta_pipe_stage1 (
        .clk(clk),
        .rst_n(rst_n),

        // ---------- 输入元数据 ----------
        .in_valid(in_valid),         // in: 当前 token 有效      
        .in_last(in_last),           // in: 当前 token 是否为整张图最后一个 token    
        .in_pos(in_pos),             // in: 当前 token 的 pos 编号，范围 0~9, 0 表示起始半窗，非有效pos
        .in_group(in_group),         // in: 当前 token 的 group 编号，范围 0~7      
        .in_fire(in_fire),           // in: 第二层启动信号    

        // ---------- 输出元数据 ----------
        .out_valid(stage1_valid),    // out: 打一拍后的 valid      
        .out_last(stage1_last),      // out: 打一拍后的 last    
        .out_pos(stage1_pos),        // out: 打一拍后的 pos  
        .out_group(stage1_group),    // out: 打一拍后的 group      
        .out_fire(stage1_fire)       // out: 打一拍后的 fire   
    );

    // ---------------------------------------------------------------------
    // ------------------------- 第二级流水：stage2 --------------------------
    // - 11 组 row_mult 并行，每组负责计算一行卷积核与对应输入窗口的乘加，输出 4ch x 2row x 4col 的半窗乘积和
    // - bias 和 元数据打拍
    // - row_mult 单元内部还内置 stage1 的数据和权重打拍
    // ---------------------------------------------------------------------

    // stage2: 11 条 kernel row 的半窗乘法阵列。
    // 每条 row_mult 现在直接只接 2 行载体，和半窗 2x4 的实际需求完全对齐。
    conv_tile_mac_row_mult u_row_mult_0 (
        .clk(clk), .rst_n(rst_n),
        // 0~1 行输入条带
        .row_window_data(pos_window_data[2*80-1:0]), 
        // 卷积核第一行
        .weight_row_data(weight_data_bus[224-1:0]),      
        .out_row_sum_bus(row_sum_bus_0)
    );
    conv_tile_mac_row_mult u_row_mult_1 (
        .clk(clk), .rst_n(rst_n),
        // 1~2 行输入条带
        .row_window_data(pos_window_data[3*80-1:1*80]), 
        // 卷积核第二行
        .weight_row_data(weight_data_bus[2*224-1:1*224]), 
        .out_row_sum_bus(row_sum_bus_1)
    );
    conv_tile_mac_row_mult u_row_mult_2 (
        .clk(clk), .rst_n(rst_n),
        // 2~3 行输入条带
        .row_window_data(pos_window_data[4*80-1:2*80]),   
        // 卷积核第三行
        .weight_row_data(weight_data_bus[3*224-1:2*224]), 
        .out_row_sum_bus(row_sum_bus_2)
    );
    conv_tile_mac_row_mult u_row_mult_3 (
        .clk(clk), .rst_n(rst_n),
        // 3~4 行输入条带
        .row_window_data(pos_window_data[5*80-1:3*80]),   
        // 卷积核第四行
        .weight_row_data(weight_data_bus[4*224-1:3*224]), 
        .out_row_sum_bus(row_sum_bus_3)
    );
    conv_tile_mac_row_mult u_row_mult_4 (
        .clk(clk), .rst_n(rst_n),
        // 4~5 行输入条带
        .row_window_data(pos_window_data[6*80-1:4*80]),   
        // 卷积核第五行
        .weight_row_data(weight_data_bus[5*224-1:4*224]), 
        .out_row_sum_bus(row_sum_bus_4)
    );
    conv_tile_mac_row_mult u_row_mult_5 (
        .clk(clk), .rst_n(rst_n),
        // 5~6 行输入条带
        .row_window_data(pos_window_data[7*80-1:5*80]),
        // 卷积核第六行
        .weight_row_data(weight_data_bus[6*224-1:5*224]),
        .out_row_sum_bus(row_sum_bus_5)
    );
    conv_tile_mac_row_mult u_row_mult_6 (
        .clk(clk), .rst_n(rst_n),
        // 6~7 行输入条带
        .row_window_data(pos_window_data[8*80-1:6*80]),
        // 卷积核第七行
        .weight_row_data(weight_data_bus[7*224-1:6*224]),
        .out_row_sum_bus(row_sum_bus_6)
    );
    conv_tile_mac_row_mult u_row_mult_7 (
        .clk(clk), .rst_n(rst_n),
        // 7~8 行输入条带
        .row_window_data(pos_window_data[9*80-1:7*80]),
        // 卷积核第八行
        .weight_row_data(weight_data_bus[8*224-1:7*224]),
        .out_row_sum_bus(row_sum_bus_7)
    );
    conv_tile_mac_row_mult u_row_mult_8 (
        .clk(clk), .rst_n(rst_n),
        // 8~9 行输入条带
        .row_window_data(pos_window_data[10*80-1:8*80]),
        // 卷积核第九行
        .weight_row_data(weight_data_bus[9*224-1:8*224]),
        .out_row_sum_bus(row_sum_bus_8)
    );
    conv_tile_mac_row_mult u_row_mult_9 (
        .clk(clk), .rst_n(rst_n),
        // 9~10 行输入条带
        .row_window_data(pos_window_data[11*80-1:9*80]),
        // 卷积核第十行
        .weight_row_data(weight_data_bus[10*224-1:9*224]),
        .out_row_sum_bus(row_sum_bus_9)
    );
    conv_tile_mac_row_mult u_row_mult_10 (
        .clk(clk), .rst_n(rst_n),
        // 10~11 行输入条带
        .row_window_data(pos_window_data[12*80-1:10*80]),
        // 卷积核第十一行
        .weight_row_data(weight_data_bus[11*224-1:10*224]),
        .out_row_sum_bus(row_sum_bus_10)
    );

    assign stage2_row_sum_bus = {
        row_sum_bus_10, row_sum_bus_9, row_sum_bus_8, row_sum_bus_7, row_sum_bus_6, row_sum_bus_5,
        row_sum_bus_4, row_sum_bus_3, row_sum_bus_2, row_sum_bus_1, row_sum_bus_0
    };

    // stage2: 元数据和偏置打拍。
    meta_pipe u_meta_pipe_stage2 (
        .clk(clk),
        .rst_n(rst_n),
        .in_valid(stage1_valid),
        .in_last(stage1_last),
        .in_pos(stage1_pos),
        .in_group(stage1_group),
        .in_fire(stage1_fire),
        .out_valid(stage2_valid),
        .out_last(stage2_last),
        .out_pos(stage2_pos),
        .out_group(stage2_group),
        .out_fire(stage2_fire)
    );

    bias_pipe u_bias_pipe_stage2 (
        .clk(clk),
        .rst_n(rst_n),
        .in_bias_bus(stage1_bias_bus),
        .out_bias_bus(stage2_bias_bus)
    );

    // stage3 / stage4: 对 32 个空间点做 11->1 归约。
    conv_tile_mac_row_add u_conv_tile_mac_row_add (
        .clk(clk),
        .rst_n(rst_n),
        .in_row_sum_bus(stage2_row_sum_bus),
        .bias_data_bus(stage2_bias_bus),
        .out_sum_bus(out_accum_bus)
    );

    // stage3: 元数据打拍
    meta_pipe u_meta_pipe_stage3 (
        .clk(clk),
        .rst_n(rst_n),

        // ---------- 输入元数据 ----------
        .in_valid(stage2_valid),   // in: 当前 token 有效                  
        .in_last(stage2_last),     // in: 当前 token 是否为整张图最后一个 token              
        .in_pos(stage2_pos),       // in: 当前 token 的 pos 编号，范围 0~9, 0 表示起始半窗，非有效pos
        .in_group(stage2_group),   // in: 当前 token 的 group 编号，范围 0~7                  
        .in_fire(stage2_fire),     // in: 第二层启动信号              

        // ---------- 输出元数据 ----------
        .out_valid(stage3_valid),  // out: 打一拍后的 valid           
        .out_last(stage3_last),    // out: 打一拍后的 last          
        .out_pos(stage3_pos),      // out: 打一拍后的 pos         
        .out_group(stage3_group),  // out: 打一拍后的 group           
        .out_fire(stage3_fire)     // out: 打一拍后的 fire         
    );


    // stage4: 元数据打拍
    meta_pipe u_meta_pipe_stage4 (
        .clk(clk),
        .rst_n(rst_n),

        // ---------- 输入元数据 ----------
        .in_valid(stage3_valid),   // in: 当前 token 有效
        .in_last(stage3_last),     // in: 当前 token 是否为整张图最后一个 token    
        .in_pos(stage3_pos),       // in: 当前 token 的 pos 编号，范围 0~9, 0 表示起始半窗，非有效pos
        .in_group(stage3_group),   // in: 当前 token 的 group 编号，范围0~7                         
        .in_fire(stage3_fire),     // in: 第二层启动信号      
        
        // ---------- 输出元数据 ----------
        .out_valid(stage4_valid),  // out: 打一拍后的 valid       
        .out_last(stage4_last),    // out: 打一拍后的 last      
        .out_pos(stage4_pos),      // out: 打一拍后的 pos     
        .out_group(stage4_group),  // out: 打一拍后的 group       
        .out_fire(stage4_fire)     // out: 打一拍后的 fire     
    );

    assign out_valid = stage4_valid;
    assign out_last  = stage4_last;
    assign out_pos   = stage4_pos;
    assign out_group = stage4_group;
    assign out_fire  = stage4_fire;

endmodule
