SmlCoke/2026-MST3314-SonicBolt/SonicBolt/src/dwconv/dwconv_core.v

`timescale 1ns / 1ps
/*
 * 模块名称: dwconv_core
 * 作者: SonicBolt 团队
 * 日期: 2026-04-08
 * 版本: v1.2
 *
 * 功能概述:
 *   DWConv 调度与主计算核心。
 *
 * 设计定位:
 *   - 本模块负责 DWConv 的调度与核心计算
 *   - DWConv 整层参数保存在独立的 dwconv_param_store 中。
 *
 * 当前数据流:
 *   - 权重和偏置仍然按 group 每拍读取
 *
 * 位宽说明:
 *   - in_stream_data: 4(ch) x 4(row) x 4(col) x 8bit = 512bit
 *   - weight_data_bus: 11(kernel row) x 4(ch) x 7(col) x 8bit = 3*96*8bit = 2304bit
 *   - bias_data_bus: 4(bias) x 16bit = 64bit
 *   - out_stream_data: 4(ch) x 2(row) x 2(col) x 8bit = 128bit
 * 调度语义:
 *   - in_stream_fire 为启动信号，只比 in_stream_valid 先一个周期到来，用来启动参数 SRAM 的预读。
 *     当信号到来时，SRAM 读使能有效，下一个周期会读出第一组参数(group = 0)
 *   - 本模块 pos/group 仅作为元数据存在，一切计算听从 conv_core 指挥
 *
 * 版本定位:
 *   - v1.1 修补bug: 补齐 fire 信号
 *   - v1.2 将杂糅状态更新逻辑重塑为三段式有限状态机
 */
module dwconv_core #(
    parameter integer M0      = 59,
    parameter integer SHIFT_N = 11
) (
    input  wire          clk,
    input  wire          rst_n,
    output reg           busy,                     // 高电平表示当前仍在处理本张图 
    output reg           done,                     // 单拍完成脉冲 

    // ---------- 输入数据流接口 ----------
    input wire           in_stream_valid,          // 输入 tile 有效
    input wire           in_stream_last,           // 输入 tile 是否是最后一个
    input wire [3:0]     in_stream_pos,            // 输入 tile 的 pos 编号
    input wire [2:0]     in_stream_group,          // 输入 tile 的 group 编号
    input wire           in_stream_fire,           // 输入的第二层启动信号
    input wire [511:0]   in_stream_data,           // 输入 tile 数据，4 x 4 x 4 x 8bit = 512bit

    // ---------- 权重/偏置交互接口 ----------
    output wire          weight_rd_en,             // DWConv 权重 SRAM 读使能
    output wire [2:0]    weight_rd_group,          // 读取哪个 group 的权重
    output wire          bias_rd_en,               // DWConv 偏置 SRAM 读使能
    output wire [2:0]    bias_rd_group,            // 读取哪个 group 的偏置
    input  wire [3*96-1:0] weight_data_bus,        // 权重 SRAM 读出数据总线
    input  wire [63:0]   bias_data_bus,            // 偏置 SRAM 读出数据总线，4个偏置，每个16bit

    // ---------- 输出数据流接口 ----------
    output wire          out_stream_valid,         // 输出元数据：有效  
    output wire          out_stream_fire,          // 输出元数据：下一层启动信号
    output wire          out_stream_last,          // 输出元数据：last
    output wire [3:0]    out_stream_pos,           // 输出元数据：位置
    output wire [2:0]    out_stream_group,         // 输出元数据：通道组  
    output wire [127:0]  out_stream_data           // 输出数据：量化后的 tile 数据
);

    // 状态机状态列表
    parameter IDLE  = 2'b00;
    parameter BUSY  = 2'b01;
    parameter DONE  = 2'b10;
    reg  [1:0] current_state;
    reg  [1:0] next_state;

    // 记录下一个待计算的 tile 编号
    reg  [3:0] issue_pos;
    reg  [2:0] issue_group;

    // MAC 输出的 INT32 tile 元数据与数据。
    wire          tile_valid;
    wire          tile_last;
    wire [3:0]    tile_pos;
    wire [2:0]    tile_group;
    wire          tile_fire;
    wire [511:0]  tile_accum_bus;

    // 量化 / ReLU 后的输出流。
    wire          quant_valid;
    wire          quant_last;
    wire [3:0]    quant_pos;
    wire [2:0]    quant_group;
    wire          quant_fire;
    wire [127:0]  quant_data;

    // 启动信号到来时，DWConv 激活 SRAM 读信号
    // 注：启动信号一旦到来，在最后一个tile到来之前的一个周期截至，一直维持高电平
    assign weight_rd_en = in_stream_fire;
    assign bias_rd_en = in_stream_fire;
    assign weight_rd_group = issue_group;
    assign bias_rd_group = issue_group;

    // 三段式状态机第一段：状态更新逻辑
    always @(posedge clk or negedge rst_n) begin
        if (!rst_n) begin
            current_state <= IDLE;
        end else begin
            current_state <= next_state;
        end
    end

    // 三段式状态机第二段：下一个状态计算逻辑
    always @(*) begin
        next_state = current_state; // 默认保持当前状态
        case (current_state)
            IDLE: begin
                if (in_stream_fire) begin
                    next_state = BUSY;
                end else begin
                    next_state = IDLE;
                end
            end

            BUSY: begin
                if (quant_valid && quant_last) begin
                    next_state = DONE;
                end else begin
                    next_state = BUSY;
                end
                 
            end

            DONE: begin
                next_state = IDLE;
            end
        endcase

    end

    // 三段式状态机设计第三段：输出逻辑
    // 1. in_stream_fire 拉高后进入 busy (第一个输入token到来时)
    // 2. 每次 in_stream_valid 推进一个 token
    // 3. 当量化输出的最后一个 token 出来时拉高 done，并退出 busy
    always @(posedge clk or negedge rst_n) begin
        if (!rst_n) begin
            issue_group <= 3'b0;
            issue_pos <= 4'b0;
            busy <= 1'b0;
            done <= 1'b0;
        end else begin
            // done 只在完成拍拉高一个周期。
            done <= 1'b0;

            case (current_state)
                IDLE: begin
                    busy <= 1'b0;
                    // 当第一个输入token到来前一个上升沿(in_stream_fire拉高)，进入busy状态
                    if (in_stream_fire) begin
                        busy <= 1'b1;
                        // 注意，当前时钟上升沿:
                        // (1) in_stream_valid信号刚变为高，但是采样仍为旧值 
                        // (2) 上一个周期 SRAM 使能信号置高， 此时SRAM 读 addr = 0 的权重以及偏置
                        // (3) 第一个 tile 的数据也马上有效
                        // (4) 下一个时钟上升沿，tile_mac 会采样 weight 以及 data 的旧值，同时 SRAM 采样当前 issue_group 的值，这个值理应对应 addr = 1 的数据
                        // (5) 所以在当前周期内，issue_group 必须置高
                        issue_group <= 3'd1;
                        issue_pos <= 4'b0;
                    end
                end

                BUSY: begin
                    // 当量化输出的最后一个token出来时，退出busy并拉高done
                    if (quant_valid && quant_last) begin
                        busy <= 1'b0;
                        done <= 1'b1;
                    end else begin 
                        busy <= 1'b1;
                    end

                    // 输入 valid 到来时更新 tile 编号组
                    if (in_stream_fire) begin
                        if (issue_group == 3'd7) begin
                            issue_group <= 3'd0;
                            issue_pos   <= issue_pos + 4'd1;
                        end else begin
                            issue_group <= issue_group + 3'd1;
                        end
                    end
                end 

                DONE: begin
                    busy <= 1'b0;
                end

                default: begin
                    busy <= 1'b0;
                end
            endcase
        end
    end


    // MAC 负责把一个 {pos, group} token 映射成完整 4ch x 4x4 INT32 tile。
    dwconv_tile_mac u_dwconv_tile_mac (
        .clk(clk),
        .rst_n(rst_n),

        // ---------- 输入元数据 ----------
        .in_valid(in_stream_valid),           // in: 当前 token 有效     
        .in_last(in_stream_last),             // in: 当前 token 是否为整张图最后一个 token   
        .in_pos(in_stream_pos),               // in: 当前 token 的 pos 编号，范围 0~8 
        .in_group(in_stream_group),           // in: 当前 token 的 group 编号，范围 0~7   
        .in_fire(in_stream_fire),             // in: fire 信号职责转换，告诉第三层开始取参数 
        
        // ---------- 输入数据(总线) ----------
        .in_data_bus(in_stream_data),         // 输入 tile 数据，4 x 4 x 4 x 8bit = 512bit
        .weight_data_bus(weight_data_bus),    // in: 当前 group 的完整 3 x 4 x 3 INT8 权重
        .bias_data_bus(bias_data_bus),        // in: 当前 group 的完整 4 个 INT16 偏置
        
        // ---------- 输出元数据 ----------
        .out_valid(tile_valid),               // out: 输出累加 tile 有效
        .out_last(tile_last),                 // out: 输出累加 tile 是否为最后一个 token
        .out_pos(tile_pos),                   // out: 输出 tile 的 pos
        .out_group(tile_group),               // out: 输出 tile 的 group
        .out_fire(tile_fire),                // out: 输出的第三层启动信号
        
        // ---------- 输出数据 ----------               
        .out_accum_bus(tile_accum_bus)        // out: 4(ch) x 4(row) x 4(col) x INT32 的输出累加结果
    );

    // 后级做 rescale + ReLU + 饱和裁剪，输出最终 8bit tile。
    rescale_relu #(
        .M0(M0),
        .SHIFT_N(SHIFT_N),
        .TILE_H(2),
        .TILE_W(2)
    ) u_dwconv_rescale_relu (
        .clk(clk),
        .rst_n(rst_n),

        // ---------- 输入元数据 -----------
        .in_valid(tile_valid),          // in: 输入 tile 有效     
        .in_last(tile_last),            // in: 输入 tile 是否为最后一个 token   
        .in_pos(tile_pos),              // in: 输入 tile 的 pos 
        .in_group(tile_group),          // in: 输入 tile 的 group   
        .in_fire(tile_fire),            // in: 输入的第三层启动信号 
        
        // ---------- 输入数据 -----------
        .in_data_bus(tile_accum_bus),   // in: 64 个 INT32 累加值

        // ---------- 输出元数据 ---------
        .out_valid(quant_valid),        // out: 输出量化 tile 有效
        .out_last(quant_last),          // out: 输出量化 tile 是否为最后一个 token
        .out_pos(quant_pos),            // out: 输出 tile 的 pos
        .out_group(quant_group),        // out: 输出 tile 的 group
        .out_fire(quant_fire),          // out: 输出的第三层启动信号

        // ----------- 输出数据 ----------
        .out_data_bus(quant_data)       // out: 64 个 INT8 输出值
    );

    assign out_stream_valid = quant_valid;
    assign out_stream_last  = quant_last;
    assign out_stream_pos   = quant_pos;
    assign out_stream_group = quant_group;
    assign out_stream_fire  = quant_fire;
    assign out_stream_data  = quant_data;

endmodule
