SmlCoke/2026-MST3314-SonicBolt/SonicBolt/src/pwconv/pwconv_input_buffer.v

`timescale 1ns / 1ps
/*
 * 模块名称: pwconv_input_buffer
 * 作者: SonicBolt 团队
 * 日期: 2026-04-09
 * 版本: v1.2
 *
 * 功能概述:
 *   逐点卷积输入侧的双缓冲 tile 缓存。
 *
 * module接口：
 *   - 输入为上游 DW 流输出的 token ，通过 in_data 输入，包含 pos/group 元数据
 *
 * 设计约定:
 *   - 上游输入顺序固定为 pos-major, group-minor，即pos=0..8，每个 pos 下 group=0..7
 *   - 偶数 pos 写入 even buffer，奇数 pos 写入 odd buffer
 *   - 每个 pos 对应一个完整 32ch x 2 x 2 INT8 tile，共 1024bit
 *   - 每个输入 token 对应其中一个 4ch x 2 x 2 INT8 group，共 128bit
 *
 * 版本定位:
 *   - v1.1 修复 bug, 更改 buf 清零的条件：只在第一个 token 到来的上一个周期（启动信号）时清理，防止buf反复清零
 *   - v1.2 将杂糅的状态转移逻辑重构为有限状态机
 */
module pwconv_input_buffer (
    input  wire          clk,
    input  wire          rst_n,
    input  wire          capture_en,
    input  wire          in_fire,         // 启动信号
    input  wire [3:0]    in_pos,
    input  wire [2:0]    in_group,        //8组，每组4ch
    input  wire [127:0]  in_data,
    output wire [1023:0] even_pos_data,
    output wire [1023:0] odd_pos_data
);

    parameter IDLE = 2'b00;
    parameter BUSY = 2'b01;
    parameter DONE = 2'b10;
    reg [1:0] current_state, next_state;

    //buffer过渡
    reg [1023:0] even_buf;
    reg [1023:0] odd_buf;

    // 三段式有限状态机设计第一段：状态更新逻辑
    always @(posedge clk or negedge rst_n) begin
        if (!rst_n) begin
            current_state <= IDLE;
        end else begin
            current_state <= next_state;
        end
    end

    // 三段式有限状态机设计第二段：下一个状态计算逻辑
    always @(*) begin
        next_state = current_state; // 默认保持当前状态
        case (current_state)
            IDLE: begin
                if (in_fire) begin
                    next_state = BUSY;
                end else begin
                    next_state = IDLE;
                end
            end
            BUSY: begin
                // 当最后一个 token（pos=8, group=7）被采样后，进入 DONE 状态
                if (capture_en && (in_pos == 4'd8) && (in_group == 3'd7)) begin
                    next_state = DONE;
                end else begin
                    next_state = BUSY;
                end
            end
            DONE: begin
                next_state = IDLE;
                
            end
            default: next_state = IDLE;
        endcase
    end

    // 三段式有限状态机设计第三段：输出逻辑
    always @(posedge clk or negedge rst_n) begin
        if (!rst_n) begin
            // 复位时清空缓冲区
            even_buf <= 1024'd0;
            odd_buf  <= 1024'd0;
        end else begin
            case (current_state)
                IDLE: begin
                    // 启动信号到来，则清空缓存区，准备等待第一个tile输入
                    if (in_fire) begin
                        even_buf <= 1024'd0;
                        odd_buf  <= 1024'd0;
                    end
                end
                BUSY: begin
                    // capture_en 本质是 in_stream_valid，每一个tile有效时，当前buffer立即采样
                    if (capture_en) begin
                        if (in_pos[0]) begin
                            odd_buf[in_group*128 +: 128] <= in_data;
                        end else begin
                            even_buf[in_group*128 +: 128] <= in_data;
                        end
                    end
                end
                DONE: begin
                    // DONE 状态下保持数据不变，等待外部处理完成后重置状态机进入 IDLE
                end
                default: ;
            endcase
        end
    end

    assign even_pos_data = even_buf;
    assign odd_pos_data  = odd_buf;

endmodule
