SmlCoke/2026-MST3314-SonicBolt/SonicBolt/src/utils/S018V3EBCDSP_X20Y4D64_PR.v

/*
    Copyright (c) 2026 SMIC
    Filename:      S018V3EBCDSP_X20Y4D64_PR.v
    IP code :      S018V3EBCDSP
    Version:       0.1.a
    CreateDate:    Apr 12, 2026

    Verilog Model for Single-PORT SRAM
    SMIC 0.18um V3EBCD

    Configuration: -instname S018V3EBCDSP_X20Y4D64_PR -rows 20 -bits 64 -mux 4 
    Redundancy: Off
    Bit-Write: Off
*/

/* DISCLAIMER                                                                      */
/*                                                                                 */  
/*   SMIC hereby provides the quality information to you but makes no claims,      */
/* promises or guarantees about the accuracy, completeness, or adequacy of the     */
/* information herein. The information contained herein is provided on an "AS IS"  */
/* basis without any warranty, and SMIC assumes no obligation to provide support   */
/* of any kind or otherwise maintain the information.                              */  
/*   SMIC disclaims any representation that the information does not infringe any  */
/* intellectual property rights or proprietary rights of any third parties. SMIC   */
/* makes no other warranty, whether express, implied or statutory as to any        */
/* matter whatsoever, including but not limited to the accuracy or sufficiency of  */
/* any information or the merchantability and fitness for a particular purpose.    */
/* Neither SMIC nor any of its representatives shall be liable for any cause of    */
/* action incurred to connect to this service.                                     */  
/*                                                                                 */
/* STATEMENT OF USE AND CONFIDENTIALITY                                            */  
/*                                                                                 */  
/*   The following/attached material contains confidential and proprietary         */  
/* information of SMIC. This material is based upon information which SMIC         */  
/* considers reliable, but SMIC neither represents nor warrants that such          */
/* information is accurate or complete, and it must not be relied upon as such.    */
/* This information was prepared for informational purposes and is for the use     */
/* by SMIC's customer only. SMIC reserves the right to make changes in the         */  
/* information at any time without notice.                                         */  
/*   No part of this information may be reproduced, transmitted, transcribed,      */  
/* stored in a retrieval system, or translated into any human or computer          */ 
/* language, in any form or by any means, electronic, mechanical, magnetic,        */  
/* optical, chemical, manual, or otherwise, without the prior written consent of   */
/* SMIC. Any unauthorized use or disclosure of this material is strictly           */  
/* prohibited and may be unlawful. By accepting this material, the receiving       */  
/* party shall be deemed to have acknowledged, accepted, and agreed to be bound    */
/* by the foregoing limitations and restrictions. Thank you.                       */  
/*                                                                                 */  

`timescale 1ns/1ps
`celldefine

module S018V3EBCDSP_X20Y4D64_PR(
                          Q,
			  CLK,
			  CEN,
			  WEN,
			  A,
			  D);

  parameter	Bits = 64;
  parameter	Word_Depth = 80;
  parameter	Add_Width = 7;

  output [Bits-1:0]      	Q;
  input		   		CLK;
  input		   		CEN;
  input		   		WEN;
  input	[Add_Width-1:0] 	A;
  input	[Bits-1:0] 		D;

  wire [Bits-1:0] 	Q_int;
  wire [Add_Width-1:0] 	A_int;
  wire                 	CLK_int;
  wire                 	CEN_int;
  wire                 	WEN_int;
  wire [Bits-1:0] 	D_int;

  reg  [Bits-1:0] 	Q_latched;
  reg  [Add_Width-1:0] 	A_latched;
  reg  [Bits-1:0] 	D_latched;
  reg                  	CEN_latched;
  reg                  	LAST_CLK;
  reg                  	WEN_latched;

  reg 			A0_flag;
  reg 			A1_flag;
  reg 			A2_flag;
  reg 			A3_flag;
  reg 			A4_flag;
  reg 			A5_flag;
  reg 			A6_flag;

  reg                	CEN_flag;
  reg                   CLK_CYC_flag;
  reg                   CLK_H_flag;
  reg                   CLK_L_flag;

  reg 			D0_flag;
  reg 			D1_flag;
  reg 			D2_flag;
  reg 			D3_flag;
  reg 			D4_flag;
  reg 			D5_flag;
  reg 			D6_flag;
  reg 			D7_flag;
  reg 			D8_flag;
  reg 			D9_flag;
  reg 			D10_flag;
  reg 			D11_flag;
  reg 			D12_flag;
  reg 			D13_flag;
  reg 			D14_flag;
  reg 			D15_flag;
  reg 			D16_flag;
  reg 			D17_flag;
  reg 			D18_flag;
  reg 			D19_flag;
  reg 			D20_flag;
  reg 			D21_flag;
  reg 			D22_flag;
  reg 			D23_flag;
  reg 			D24_flag;
  reg 			D25_flag;
  reg 			D26_flag;
  reg 			D27_flag;
  reg 			D28_flag;
  reg 			D29_flag;
  reg 			D30_flag;
  reg 			D31_flag;
  reg 			D32_flag;
  reg 			D33_flag;
  reg 			D34_flag;
  reg 			D35_flag;
  reg 			D36_flag;
  reg 			D37_flag;
  reg 			D38_flag;
  reg 			D39_flag;
  reg 			D40_flag;
  reg 			D41_flag;
  reg 			D42_flag;
  reg 			D43_flag;
  reg 			D44_flag;
  reg 			D45_flag;
  reg 			D46_flag;
  reg 			D47_flag;
  reg 			D48_flag;
  reg 			D49_flag;
  reg 			D50_flag;
  reg 			D51_flag;
  reg 			D52_flag;
  reg 			D53_flag;
  reg 			D54_flag;
  reg 			D55_flag;
  reg 			D56_flag;
  reg 			D57_flag;
  reg 			D58_flag;
  reg 			D59_flag;
  reg 			D60_flag;
  reg 			D61_flag;
  reg 			D62_flag;
  reg 			D63_flag;

  reg                   WEN_flag; 
  reg [Add_Width-1:0]   A_flag;
  reg [Bits-1:0]        D_flag;
  reg                   LAST_CEN_flag;
  reg                   LAST_WEN_flag;
  reg [Add_Width-1:0]   LAST_A_flag;
  reg [Bits-1:0]        LAST_D_flag;

  reg                   LAST_CLK_CYC_flag;
  reg                   LAST_CLK_H_flag;
  reg                   LAST_CLK_L_flag;

  wire                  CE_flag;
  wire                  WR_flag;
  reg    [Bits-1:0] 	mem_array[Word_Depth-1:0];

  integer      i;
  integer      n;

  buf dout_buf[Bits-1:0] (Q, Q_int);
  buf (CLK_int, CLK);
  buf (CEN_int, CEN);
  buf (WEN_int, WEN);
  buf a_buf[Add_Width-1:0] (A_int, A);
  buf din_buf[Bits-1:0] (D_int, D);   

  assign Q_int=Q_latched;
  assign CE_flag=!CEN_int;
  assign WR_flag=(!CEN_int && !WEN_int);

  always @(CLK_int)
    begin
      casez({LAST_CLK, CLK_int})
        2'b01: begin
          CEN_latched = CEN_int;
          WEN_latched = WEN_int;
          A_latched = A_int;
          D_latched = D_int;
          rw_mem;
        end
        2'b10,
        2'bx?,
        2'b00,
        2'b11: ;
        2'b?x: begin
	  for(i=0;i<Word_Depth;i=i+1)
    	    mem_array[i]={Bits{1'bx}};
    	  Q_latched={Bits{1'bx}};
          rw_mem;
          end
      endcase
    LAST_CLK=CLK_int;
   end

  always @(CEN_flag
           	or WEN_flag
		or A0_flag
		or A1_flag
		or A2_flag
		or A3_flag
		or A4_flag
		or A5_flag
		or A6_flag
		or D0_flag
		or D1_flag
		or D2_flag
		or D3_flag
		or D4_flag
		or D5_flag
		or D6_flag
		or D7_flag
		or D8_flag
		or D9_flag
		or D10_flag
		or D11_flag
		or D12_flag
		or D13_flag
		or D14_flag
		or D15_flag
		or D16_flag
		or D17_flag
		or D18_flag
		or D19_flag
		or D20_flag
		or D21_flag
		or D22_flag
		or D23_flag
		or D24_flag
		or D25_flag
		or D26_flag
		or D27_flag
		or D28_flag
		or D29_flag
		or D30_flag
		or D31_flag
		or D32_flag
		or D33_flag
		or D34_flag
		or D35_flag
		or D36_flag
		or D37_flag
		or D38_flag
		or D39_flag
		or D40_flag
		or D41_flag
		or D42_flag
		or D43_flag
		or D44_flag
		or D45_flag
		or D46_flag
		or D47_flag
		or D48_flag
		or D49_flag
		or D50_flag
		or D51_flag
		or D52_flag
		or D53_flag
		or D54_flag
		or D55_flag
		or D56_flag
		or D57_flag
		or D58_flag
		or D59_flag
		or D60_flag
		or D61_flag
		or D62_flag
		or D63_flag
           	or CLK_CYC_flag
           	or CLK_H_flag
           	or CLK_L_flag)
    begin
      update_flag_bus;
      CEN_latched = (CEN_flag!==LAST_CEN_flag) ? 1'bx : CEN_latched ;
      WEN_latched = (WEN_flag!==LAST_WEN_flag) ? 1'bx : WEN_latched ;
      for (n=0; n<Add_Width; n=n+1)
      A_latched[n] = (A_flag[n]!==LAST_A_flag[n]) ? 1'bx : A_latched[n] ;
      for (n=0; n<Bits; n=n+1)
      D_latched[n] = (D_flag[n]!==LAST_D_flag[n]) ? 1'bx : D_latched[n] ;
      LAST_CEN_flag = CEN_flag;
      LAST_WEN_flag = WEN_flag;
      LAST_A_flag = A_flag;
      LAST_D_flag = D_flag;
      LAST_CLK_CYC_flag = CLK_CYC_flag;
      LAST_CLK_H_flag = CLK_H_flag;
      LAST_CLK_L_flag = CLK_L_flag;
      rw_mem;
   end
      
  task rw_mem;
    begin
      if(CEN_latched==1'b0)
        begin
	  if(WEN_latched==1'b1) 	
   	    begin
   	      if(^(A_latched)==1'bx)
   	        Q_latched={Bits{1'bx}};
   	      else
		Q_latched=mem_array[A_latched];
       	    end
          else if(WEN_latched==1'b0)
   	    begin
   	      if(^(A_latched)==1'bx)
   	        begin
                  x_mem;
   	          Q_latched={Bits{1'bx}};
   	        end   	        
   	      else
		begin
   	          mem_array[A_latched]=D_latched;
   	          Q_latched=mem_array[A_latched];
   	        end
   	    end
	  else 
     	    begin
   	      Q_latched={Bits{1'bx}};
   	      if(^(A_latched)===1'bx)
                for(i=0;i<Word_Depth;i=i+1)
   		  mem_array[i]={Bits{1'bx}};   	        
              else
		mem_array[A_latched]={Bits{1'bx}};
   	    end
	end  	    	    
      else if(CEN_latched===1'bx)
        begin
	  if(WEN_latched===1'b1)
   	    Q_latched={Bits{1'bx}};
	  else 
	    begin
   	      Q_latched={Bits{1'bx}};
	      if(^(A_latched)===1'bx)
                x_mem;
              else
		mem_array[A_latched]={Bits{1'bx}};
   	    end	      	    	  
        end
    end
  endtask
      
   task x_mem;
   begin
     for(i=0;i<Word_Depth;i=i+1)
     mem_array[i]={Bits{1'bx}};
   end
   endtask

  task update_flag_bus;
  begin
    A_flag = {
		A6_flag,
		A5_flag,
		A4_flag,
		A3_flag,
		A2_flag,
		A1_flag,
            A0_flag};
    D_flag = {
		D63_flag,
		D62_flag,
		D61_flag,
		D60_flag,
		D59_flag,
		D58_flag,
		D57_flag,
		D56_flag,
		D55_flag,
		D54_flag,
		D53_flag,
		D52_flag,
		D51_flag,
		D50_flag,
		D49_flag,
		D48_flag,
		D47_flag,
		D46_flag,
		D45_flag,
		D44_flag,
		D43_flag,
		D42_flag,
		D41_flag,
		D40_flag,
		D39_flag,
		D38_flag,
		D37_flag,
		D36_flag,
		D35_flag,
		D34_flag,
		D33_flag,
		D32_flag,
		D31_flag,
		D30_flag,
		D29_flag,
		D28_flag,
		D27_flag,
		D26_flag,
		D25_flag,
		D24_flag,
		D23_flag,
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
    $setuphold(posedge CLK &&& WR_flag,negedge D[63],0.500,0.250,D63_flag);
    $setuphold(posedge CLK &&& CE_flag,posedge WEN,0.500,0.250,WEN_flag);
    $setuphold(posedge CLK &&& CE_flag,negedge WEN,0.500,0.250,WEN_flag);
  endspecify

endmodule

`endcelldefine
