SmlCoke/2026-MST3314-SonicBolt/SonicBolt/src/utils/rescale_relu.v

`timescale 1ns / 1ps
/*
 * 模块名称: rescale_relu
 * 作者: SonicBolt 团队
 * 日期: 2026-03-30
 * 版本: v1.0
 *
 * 功能概述: 
 *   通用模块，现在可以实现对 Conv 层和 DWConv 层的计算结果进行量化和激活
 *   只需要设置 Parameter TILE_H 和 TILE_W 即可适配不同的 tile 大小
 *
 * 当前角色:
 *   - 主通路量化与激活模块。
 *   - 将 conv_tile_mac 产生的 16 个 INT32 值压缩成 16 个 INT8 值。
 *
 * 位宽说明:
 *   - 输入  4 x TILE_H x TILE_W x 32bit
 *   - 输出  4 x TILE_H x TILE_W x 8bit
 *   - 乘法级输出为 4 x TILE_H x TILE_W x 48bit，乘法结果直接放在 stage1_rescale_bus 上
 *
 * 原有流水说明保留:
 *   - 第一级: INT32 x M0，移位
 *   - 第二级: ReLU、饱和到 INT8
 *
 * 版本定位:
 */
module rescale_relu #(
    parameter integer M0      = 59,
    parameter integer SHIFT_N = 11,
    parameter integer TILE_H = 2,
    parameter integer TILE_W = 2
) (
    input  wire          clk,             // 时钟
    input  wire          rst_n,           // 低有效复位

    // ---------- 输入元数据 -----------
    input  wire          in_valid,        // 输入 tile 有效
    input  wire          in_last,         // 输入 tile 是否为最后一个 token
    input  wire [3:0]    in_pos,          // 输入 tile 的 pos
    input  wire [2:0]    in_group,        // 输入 tile 的 group
    input  wire          in_fire,         // 输入的第三层启动信号

    // ---------- 输入数据 -----------
    input  wire [4*TILE_H*TILE_W*32-1:0] in_data_bus,  // 4 x TILE_H x TILE_W 个 INT32 结果

    // ---------- 输出元数据 ---------
    output wire          out_valid,       // 输出量化 tile 有效
    output wire          out_last,        // 输出量化 tile 是否为最后一个 token
    output wire [3:0]    out_pos,         // 输出 tile 的 pos
    output wire [2:0]    out_group,       // 输出 tile 的 group
    output wire          out_fire,        // 输出的第三层启动信号

    // ----------- 输出数据 ----------
    output wire [4*TILE_H*TILE_W*8-1:0]  out_data_bus     // 4 x TILE_H x TILE_W 个 INT8 输出值
);

    // 第一级量化结果位宽: 4 x TILE_H x TILE_W x 32
    wire [4*TILE_H*TILE_W*32-1:0] stage1_rescale_bus; // 第一级量化结果

    // stage1: 元数据的打拍输出
    wire       stage1_valid;
    wire       stage1_last;
    wire [3:0] stage1_pos;
    wire [2:0] stage1_group;
    wire       stage1_fire;

    // stage2: 元数据的打拍输出
    wire       stage2_valid;
    wire       stage2_last;
    wire [3:0] stage2_pos;
    wire [2:0] stage2_group;
    wire       stage2_fire;

    // ---------------------------------------------------------------------
    // ------------------------- 第一级流水：stage1 --------------------------
    // - 4 x TILE_H x TILE_W 个 INT32 输入乘以 M0，得到 4 x TILE_H x TILE_W 个 INT48 输出，然后进行移位，得到 4 x TILE_H x TILE_W 个 INT32 输出
    // - 元数据(valid, last, pos, group)打拍
    // ---------------------------------------------------------------------
    rescale #(
        .M0(M0),
        .SHIFT_N(SHIFT_N),
        .TILE_H(TILE_H),
        .TILE_W(TILE_W)
    ) u_rescale (
        .clk(clk),
        .rst_n(rst_n),
        .in_data_bus(in_data_bus),
        .out_rescale_bus(stage1_rescale_bus)
    );

    // stage1: 元数据打拍
    meta_pipe u_meta_pipe_stage1 (
        .clk(clk),
        .rst_n(rst_n),
        // 输入元数据
        .in_valid(in_valid),
        .in_last(in_last),
        .in_pos(in_pos),
        .in_group(in_group),
        .in_fire(in_fire),
        // 输出元数据
        .out_valid(stage1_valid),
        .out_last(stage1_last),
        .out_pos(stage1_pos),
        .out_group(stage1_group),
        .out_fire(stage1_fire)
    );


    // ---------------------------------------------------------------------
    // ------------------------- 第二级流水：stage2 --------------------------
    // - 4 x TILE_H x TILE_W 个 INT32 进行 ReLU 和饱和截断
    // - 元数据(valid, last, pos, group)打拍
    // ---------------------------------------------------------------------
    // stage2: 4 x TILE_H x TILE_W 个 INT32 进行 ReLU 和 INT8 饱和阶段
    relu_saturate  #(
        .TILE_H(TILE_H),
        .TILE_W(TILE_W)
    ) u_relu_saturate (
        .clk(clk),
        .rst_n(rst_n),
        .in_shift_bus(stage1_rescale_bus),
        .out_data_bus(out_data_bus)
    );

    // stage2: 元数据打拍
    meta_pipe u_meta_pipe_stage2 (
        .clk(clk),
        .rst_n(rst_n),
        .in_valid(stage1_valid),
        .in_last(stage1_last),
        .in_pos(stage1_pos),
        .in_group(stage1_group),
        .in_fire(stage1_fire),
        .out_valid(stage2_valid),
        .out_last(stage2_last),
        .out_pos(stage2_pos),
        .out_group(stage2_group),
        .out_fire(stage2_fire)
    );

    assign out_valid = stage2_valid;
    assign out_last  = stage2_last;
    assign out_pos   = stage2_pos;
    assign out_group = stage2_group;
    assign out_fire  = stage2_fire;

endmodule
