SmlCoke/2026-MST3314-SonicBolt/(commit log)

2026-03-02 fj: Repo Init
    [Param_Conv_Bias.txt, Param_Conv_Weight.txt, Param_DWConv_Bias.txt, Param_DWConv_Weight.txt, Param_Linear_Bias.txt, Param_Linear_Weight.txt, Param_PWConv_Bias.txt, Param_PWConv_Weight.txt]
2026-03-06 fj: 恢复demo1代码
2026-03-16 fj: Add first version of SonicBolt-Conv
    [Param_Conv_Bias.txt, Param_Conv_Weight.txt, Param_DWConv_Bias.txt, Param_DWConv_Weight.txt, Param_Linear_Bias.txt, Param_Linear_Weight.txt, Param_PWConv_Bias.txt, Param_PWConv_Weight.txt]
2026-03-17 fj: Delete old data
    [Param_Conv_Bias.txt, Param_Conv_Weight.txt, Param_DWConv_Bias.txt, Param_DWConv_Weight.txt, Param_Linear_Bias.txt, Param_Linear_Weight.txt, Param_PWConv_Bias.txt, Param_PWConv_Weight.txt]
2026-03-18 fj: shrinke pipeline stage of Conv MAC to 3
2026-03-29 Add: Conv-DWConv tb but sim fail
    [conv_subsystem.v, dwconv_core.v, dwconv_subsystem.v]
2026-04-01 fj: supply comment stage1
2026-04-02 fj: Replace sram behavior model with memory compiler model
    [S018V3EBCDSP_X8Y4D112_PR.v, S018V3EBCDSP_X8Y4D128_PR.v, S018V3EBCDSP_X8Y4D64_PR.v, S018V3EBCDSP_X8Y4D80_PR.v, S018V3EBCDSP_X8Y4D96_PR.v, conv_param_store.v, conv_shared_input_buffer.v, conv_subsystem.v]
2026-04-02 fj: Replace sram module
    [conv_param_store.v, dwconv_core.v, dwconv_param_store.v, dwconv_subsystem.v, pwconv_param_store.v]
2026-04-03 fj: delete error post_process files
    [post_process_fc_bias_store.v, post_process_fc_rescale.v, post_process_fc_weight_sram_if.v, post_process_maxpool.v, post_process_subsystem.v, pwconv_core.v]
2026-04-06 fj: repair bug of fc_mac
    [fc_mac.v]
2026-04-08 fj: Ping-Pong Buffer Update Stage1
2026-04-08 fj: Ping-Pong Buffer Update Stage 2
2026-04-08 fj: FSM Restructing Stage 1
2026-04-13 Revert "fj: remove sram writing api step1"
    This reverts commit aafaf5c88384cd1fa95146dc41994bf9a5306cc2.
    [cnn_sim_tb.v, cnn_test_tb.v, run_cnn_tb_common.py]
