SmlCoke/2026-MST3314-SonicBolt/(notices)

Notices in the files:
README.md:
License: MIT
